Kmedrano101/px4_drone_dev/README.md

**Languages:** [English](README.md) | [Español](docs/README.es.md)

# px4_drone_dev

Development journal, tooling, and configuration for bringing up a custom PX4
drone toward autonomous **indoor navigation** — optical flow + LiDAR altitude,
magnetometer-free heading, and offboard control from a Raspberry Pi 4 companion
over ROS 2 / uXRCE-DDS.

> Work-in-progress engineering log: every fix is diagnosed from `.ulog` flight
> logs and documented step by step.

## Table of Contents

- [Overview](#overview)
- [Installation](#installation)
- [Usage](#usage)
- [Project Resources](#project-resources)
- [Contributing](#contributing)
- [License](#license)
- [Contact](#contact)

## Overview

**Hardware**
- **FC:** HKUST NxtPX4v2 (STM32H7) · FC#1 PX4 v1.17.0 (custom board build) · FC#2 PX4 v1.14.3 (vendor stock, 2nd drone)
- **Companion:** Raspberry Pi 4 · Ubuntu 24.04 · ROS 2 Jazzy
- **Sensors:** MicoAir MTF-01P (optical flow + 12 m LiDAR) · M100-5883 GPS/compass
- **Airframe:** Quad-X · T-Motor F90 2806.5 · HQProp 7040 · 6S

**Milestones**
- ✅ First flights (Stabilized / Altitude / Position outdoor, 0.71 m GPS hold)
- ✅ MTF-01P optical-flow + LiDAR integrated over MAVLink (TEL4/UART8)
- ✅ Offboard link RPi ⇄ FC via uXRCE-DDS (domain-id + px4_msgs aligned)
- ✅ Firmware optimized (removed FW/VTOL modules → FLASH 98.5% → 92%)
- ✅ 2nd drone (FC#2, vendor PX4 1.14.3) brought up — MTF-01P on TEL4 via SD `extras.txt`, 97 params migrated from FC#1
- ✅ FC#2 moved to **own PX4 1.17 build** (fork `nxt-dual-custom`, flash 83%) to enable the **QMC5883P compass**; offboard uXRCE-DDS re-verified on 1.17 (`px4_msgs` v1.17.0)
- ✅ **Outdoor GPS (ZED-F9P) validated** in open sky: autonomous sub-meter (`eph` 0.79–1.01 m, 16–21 sats, instant 3D fix) and **RTK cm** via IGN SPTR **VRS** (QGC NTRIP)
- ✅ **Outdoor estimation profile applied** (GPS fused `EKF2_GPS_CTRL=7`, baro height, flow/range off) with switchable **indoor↔outdoor profile files** (QGC *Load from file* or CLI); **motor-output map fixed** (motor 2↔3 cross-wiring → `PWM_MAIN_FUNC = 101,104,103,102`)
- ✅ **RTK validated in the field** (IGN NTRIP `VRS3M`): RTK-fixed 91/91 samples, position scatter 10 cm → **2 mm** (×59). Absolute location ≈ same (~1 m) as autonomous; the real win is **stability** for position hold and a quieter feed to EKF2 — see [report](reports/2026-10-27_campo-rtk-validado-fixed.md)
- ✅ Simulación Gazebo del dron real (RJX F450 + MTF-01P + D500) en la zona indoor escaneada
- ✅ Heading and position without a compass via **2D SLAM (LD19) → external vision**: EV fusion validated, ground arming in Offboard
- ✅ 360° obstacle stop from the raw 2D scan, honest EV variance, and onboard-computer load logged with every test
- 🔄 **Three MPC variants** built on the Pi: kinematic (4.4–9.3 ms), **MPC+** with a disturbance state (same binary, offset-free), and a **CTBR NMPC** with attitude in the model (2.7 ms mean, 5.9 ms max; engages only during the hold) — none flown yet
- 🔄 Altitude hold capped by **1D LiDAR saturation** over dark concrete: usable band ≤1 m
- ✅ **False obstacles on takeoff** solved: the 2D LiDAR's burst while the props spin (none with props stopped) is separated by the obstacle's **real width** — dust 0.03–0.09 m, a 40 cm pillar 0.40 m, a real obstacle 1.18–1.83 m
- ✅ **Bench without props (21-Oct):** all four cycles arm and reach TAKEOFF; forced disarm accepted in 12 ms
- ✅ **SLAM pose 1 Hz → 6.3 Hz**: karto rejected 70–80 % of LD19 scans (variable ray count, the 1.2 Hz behind the 18-Sep crash); a fixed-size scan relay lets all through — bench-measured, flight pending
- ⏳ In-flight PID vs MPC comparison (takeoff – 30 s hold – land at 0.8 m) — the 20-Oct outing was lost whole: CycloneDDS pinned to `eth0` with no Ethernet in the field (fixed and verified 21-Oct)
- ⏳ Full indoor navigation with 3D LiDAR (Livox + FAST-LIO)

## Installation

Analysis tooling (Python) for the `.ulog` scripts:

```bash
python3 -m venv .venv && source .venv/bin/activate
pip install pyulog matplotlib numpy
```

## Usage

Log analysis tools live in [`scripts/`](scripts/README.md) and generate **visual
plots**. Drop `.ulg` files in `scripts/input/` and run:

```bash
cd scripts
cp <your>.ulg input/
python3 analyze_temperature.py   # FC temperature (baro + IMU) with thresholds
python3 analyze_motor_noise.py   # motor outputs / saturation + torque
python3 analyze_takeoff.py       # takeoff diagnosis (altitude/motors/estimator)
```

Plots are written to `scripts/output/<log>/*.png`. See [`scripts/README.md`](scripts/README.md).

## Project Resources

**Documentation — engineering reports** (`docs/`, index in [docs/README.md](docs/README.md): `referencia/` stable docs · `planes/` dated plans & protocols · `publicaciones/` literature & paper proposals · `historico/` bring-up reports)
- [Platform: hardware, firmware & comms](docs/referencia/PLATAFORMA_HARDWARE.md) — full spec sheet + SUPER reference
- [Flight bring-up report](docs/historico/INFORME_VUELO_DRONE.md) — 4 problems solved, reference config, lessons
- [Motor-noise = yaw saturation](docs/historico/DIAGNOSTICO_RUIDO_MOTORES_YAW.md) — "loud motors on arming" root cause
- [Offboard RPi ⇄ FC (uXRCE-DDS)](docs/referencia/CONFIGURACION_OFFBOARD_RPI4.md) — companion link setup
- [MTF-01P flow + LiDAR integration](docs/referencia/INTEGRACION_MTF-01P_FLOW_LIDAR.md) — sensor bring-up saga
- [Indoor parameter reference](docs/referencia/PARAMETROS_INDOOR.md) — every GPS-free indoor param, ranked by importance
- [Direct MAVLink scripting](docs/referencia/CONEXION_MAVLINK_SCRIPTS.md) — talk to the FC over USB cable or radio without QGC
- [Working method](docs/referencia/METODOLOGIA_TRABAJO.md) — how analysis, reports, memory and FC changes are handled
- [2D-LiDAR EV test plan](docs/planes/2026-09-16_test_lidar2d_ev_offboard.md) — external vision from a 2D scanner, 1D LiDAR for altitude
- [Research gaps for publication](docs/publicaciones/2026-10-01_gaps_publicacion.md) — literature review vs what the group already has; where the next paper should go
- [Smooth-and-repeatable tuning plan](docs/planes/2026-10-19_plan_tuning_takeoff_hold_land.md) — the order of layers (mechanics → estimation → rates → thrust → outer loop), what to measure per phase, candidate targets
- [FC parameters for smooth flight](docs/planes/2026-10-20_parametros_vuelo_suave_produccion.md) — what the FC holds today (903-param dump), what PX4 does to our setpoints during takeoff, and what to change in order of effect
- [Bench tests without props](docs/planes/2026-10-21_pruebas_banco_sin_helices.md) — bench mode: forced disarm N s after TAKEOFF (21196) so the motors never wind up to 100 %; the order of tests before going back to the field
- [Outdoor GPS (ZED-F9P) position/altitude hold](docs/planes/2026-10-21_outdoor_gps_zedf9p_position_hold.md) — the F9P gives position but no heading; **outdoor estimation profile applied** (GPS fused), switchable indoor↔outdoor profiles (QGC/CLI), wiring and pre-arm checklist
- [Motor-output map & geometry](docs/referencia/PLATAFORMA_HARDWARE.md) — Quad-X geometry (`CA_ROTOR*`) vs output map (`PWM_MAIN_FUNC*`); the motor 2↔3 cross-wiring fix (2026-10-27)
- [Companion for a MID-360S](docs/planes/2026-10-19_companion_mid360s_slam.md) — what would replace the Pi for 3D LiDAR SLAM: evidence found, alternatives, acceptance test before buying

**Diagnostic reports** (companion / RPi) — see [`reports/`](reports/README.md)
- [MTF-01 EKF2 tuning — indoor flow](reports/2026-07-23_mtf01-ekf2-tuning.md)
- [FC#2 vendor 1.14.3 — MTF-01P + param migration](reports/2026-09-04_fc2-vendor-1143-mtf01p-migracion.md)

**Firmware versions** — see [backups/firmware/INDEX.md](backups/firmware/INDEX.md).

**Parameter profiles & backups** (`backups/`)
- [Indoor estimation profile](backups/profiles/perfil_indoor_flujo-lidar.params) — optical-flow + LiDAR, GPS off (`EKF2_GPS_CTRL=0`, height = range)
- [Outdoor estimation profile](backups/profiles/perfil_outdoor_gps.params) — GPS fused + compass, flow/range off (`EKF2_GPS_CTRL=7`, baro height) — **applied 2026-10-27**
- Partial param files (9 keys: estimation + RC/datalink-loss failsafe → **Land**) to switch via QGC *Tools → Load from file* or `scripts/mavlink/load_params.py`; they leave motors/tuning/battery untouched. Reboot the FC after switching.
- Full state snapshots (939 params, both with the motor-map fix): `backups/backup_fc_2026-10-27_outdoor-motorfix.params` (current) and `..._indoor-motorfix.params`.

**Reference platform** — this build replicates the [SUPER](https://github.com/hku-mars/SUPER) MAV
platform from HKU MaRS Lab ([hardware BOM](https://github.com/hku-mars/SUPER-Hardware)) as a base
for further work. Differences are tracked in [docs/referencia/PLATAFORMA_HARDWARE.md](docs/referencia/PLATAFORMA_HARDWARE.md) §7.
Each version ships the flashable `.px4` (QGC → Custom firmware) plus its
`board_config.diff` to rebuild; `.bin`/`.elf` are skipped.

## Contributing

Personal R&D journal — issues and suggestions welcome. See the reports in
`docs/` for the current state and open questions.

## License

Distributed under the [MIT License](LICENSE).

## Contact

Kevin Medrano — [kevin.ejem18@gmail.com](mailto:kevin.ejem18@gmail.com) · [@Kmedrano101](https://github.com/Kmedrano101)
