Kmedrano101/px4_drone_dev/reports/README.md

# reports/ — Reportes de diagnóstico (companion / RPi)

Canal compartido para **reportes generados desde la Raspberry Pi** (companion)
o durante pruebas de campo, para analizarlos y resolverlos.

Cada reporte describe **un problema concreto**: contexto, síntomas observados,
lecturas directas (consola MAVLink / topics ROS 2), e hipótesis a investigar.
Así el diagnóstico se hace con datos, no de memoria.

## Convención de nombres

```
YYYY-MM-DD_tema-corto.md
```
Ejemplos:
- `2026-07-23_mtf01-flow-no-valida-indoor.md`
- `2026-07-25_offboard-rx-cero.md`

## Cómo añadir un reporte desde la RPi

**Opción A — generar en la RPi y traer al repo (dev machine):**
```bash
# en la RPi: genera el reporte (ej. reporte.md)
scp reporte.md kmedrano@<dev-ip>:/home/kmedrano/src/drone_tunning/reports/
# en la dev machine:
cd /home/kmedrano/src/drone_tunning
git add reports/ && git commit -m "report: <tema>" && git push
```

**Opción B — clonar el repo en la RPi y commitear directo:**
```bash
# en la RPi (una vez):
git clone git@github.com:Kmedrano101/px4_drone_dev.git
# luego, por cada reporte:
cp reporte.md px4_drone_dev/reports/
cd px4_drone_dev && git pull --rebase && git add reports/ && git commit -m "report: <tema>" && git push
```

## Plantilla

Usa [`TEMPLATE.md`](TEMPLATE.md) como base para cada reporte nuevo — mantiene la
estructura consistente (contexto, síntoma, lecturas, hipótesis, qué no se tocó).

## Índice de reportes

| Fecha | Reporte | Estado |
|---|---|---|
| 2026-07-23 | [MTF-01 EKF2 tuning (flow no valida indoor)](2026-07-23_mtf01-ekf2-tuning.md) | ✅ Caso B confirmado en vuelo (2026-08-12): flow no fusiona sin yaw → necesita Livox+FAST-LIO |
| 2026-08-24 | [Motor M4 — tornillo haciendo contacto con bobina](2026-08-24_motor4-tornillo-bobina.md) | ✅ Resuelto — tornillo alejado, todos los motores OK |
| 2026-09-04 | [FC#2 vendor 1.14.3 — MTF-01P integrado + migración de params](2026-09-04_fc2-vendor-1143-mtf01p-migracion.md) | ✅ Sensor OK y 97 params migrados · ⛔ **sin magnetómetro** → mismo bloqueo de yaw que 2026-07-23 |
| 2026-09-08 | [EKF2 y flujo óptico en el SITL](2026-09-08_ekf2-no-converge-sitl.md) | ✅ **Resuelto** — 3 params EKF2 mal migrados rompían la fusión de flujo; ciclo completo verificado. Queda arranque intermitente ~2/7 |
| 2026-09-11 | [Vuelo offboard 1 — flujo cae en vuelo, failsafe, re-entrada en OFFBOARD](2026-09-11_offboard-vuelo1-flujo-failsafe.md) | 🔄 Flujo inútil >0.5 m en vuelo → failsafe a ALTCTL · ⚠️ PX4 volvió solo a OFFBOARD; lo paró el kill |
| 2026-09-11 | [Vuelo offboard 2 — escape vertical a ~25 m por el LiDAR](2026-09-11_offboard-vuelo2-runaway-rango.md) | ⛔ Casi accidente: `HGT_REF=2` + setpoint +2 m → el LiDAR baja al perder el suelo, el EKF cree descender y sube a ~25 m. Cambios obligatorios |
| 2026-09-11 | [Estimador y sensores en los vuelos offboard](2026-09-11_estimador-sensores-offboard.md) | ⚠️ Saltos de altura = cambios de instancia EKF (acelerómetro vertical malo en EKF0 el 43%); LiDAR sin retorno el 58% en el aire; sin magnetómetro |
| 2026-09-17 | [Validación SLAM 2D manual y mapa congelado](2026-09-17_slam-manual-ld19-congelado.md) | ✅ **Resuelto** — `minimum_travel_distance: 0.0` permite a `slam_toolbox` procesar scans sin odometría de ruedas; mapa y pose en vivo validados |
| 2026-09-17 | [Validación EV al EKF2 en tierra (Prueba 2)](2026-09-17_prueba2-ev-ekf-fusion-validada.md) | ✅ **Éxito** — EKF2 fusiona EV en `POSE_FRAME_NED`; `heading_good_for_control=True` sin mag, `eph=0.046 m`, handshake listo para vuelo |
| 2026-09-17 | [Armado en tierra en Offboard (Prueba 2b)](2026-09-17_prueba2b-armado-tierra-offboard-validado.md) | ✅ Offboard + armado + 5 s en ralentí + auto-desarme |
| 2026-09-18 | [Log 158 — takeoff EV y escape en el patrón en cruz](2026-09-18_takeoff-ev-log158-caida-stabilized.md) | ⛔ ~~Altura y LiDAR 1D bien~~ → **corregido el 2026-10-16**: el LiDAR 1D estaba saturando y el hover real fue a 1.66–1.82 m, no a 1 m (ver reporte del 2026-10-16). En la cruz el **SLAM 2D perdió el tracking** (1.2 Hz, ventana ±0.25 m) y el puente **ocultó su covarianza** → ~3 m de escape; la caída final fue Stabilized con gas a cero |
| 2026-10-14 | [MPC compilado en Raspberry Pi](2026-10-14_mpc-compilado-rpi.md) | 🔄 Compilado e instalado; solver y carga de bibliotecas verificados, sin prueba de vuelo |
| 2026-10-16 | [El LiDAR 1D del MTF-01P se satura sobre suelo oscuro](2026-10-16_lidar1d-saturacion-reflectividad.md) | 🔄 Causa identificada: reflectividad del hormigón (techo 2.53 m = spec del TF-Luna al 10 %). **Zona útil ≤1 m** · `EKF2_RNG_A_HMAX` debe bajar a 1.0 · corrige la altura del log 158 |
| 2026-10-16 | [El barómetro a 79 °C y la deriva de z en tierra](2026-10-16_baro-temperatura-deriva-z.md) | ⚠️ SPL06 sano (0 errores, 31 Hz) pero a **79 °C**; con la presión plana la z del EKF deriva **3 mm/s** (11 cm en 32 s). Confirma que la IMU no puede dar altura y que la ayuda del LiDAR 1D es la que ancla la z |
| 2026-10-19 | [PID y MPC — pruebas de 0.8 m detenidas por las guardas](2026-10-19_pid-mpc-pruebas-guardas-rpi.md) | ⚠️ PID abortó por `sigma_xy=0.311 m`; MPC subió parcialmente y aterrizó por obstáculo a 0.95 m. Las guardas funcionaron, pero no hay comparación PID vs MPC válida |
| 2026-10-20 | [Zona ciega circular y guarda SLAM en ciclos PID/MPC](2026-10-20_zona-ciega-circular-ciclos.md) | Radio ciego de 0.35 m en 360°; guarda SLAM desactivada en los launches de ciclo; 288 casos sintéticos correctos |
| 2026-10-20 | [Por qué los ciclos PID y MPC no despegaron: retornos falsos al despegar](2026-10-20_falsos-obstaculos-al-despegar.md) | ✅ **Causa cerrada** — no había obstáculo: con las hélices paradas el LiDAR ve 0 retornos en 655 barridos; con las hélices girando aparece una ráfaga de 0.6–1.6 s en todos los rumbos. Solución: **filtro de ancho mínimo de obstáculo** (el polvo da cuerdas de 0.03–0.09 m, un pilar de 40 cm da 0.40 m, el obstáculo real del accidente 1.18–1.83 m) |
| 2026-10-21 | [Las cinco corridas del 20-oct no volaron: CycloneDDS clavado a `eth0`](2026-10-21_cinco-corridas-sin-dds-eth0.md) | ✅ **Causa cerrada** — sin Ethernet en el campo Cyclone se negó a crear el dominio y ningún nodo arrancó (ni launch, ni bag, ni sysmon). `presence_required="false"` + `lo`, verificado en los tres estados de red; la webui ahora comprueba DDS antes de lanzar |
| 2026-10-21 | [Banco sin hélices: los cuatro ciclos arman, y el SLAM va a 1 Hz](2026-10-21_banco-cuatro-controladores-slam-1hz.md) | ✅ secuencia hasta el despegue demostrada en PID, MPC, MPC+ y CTBR; desarme forzado aceptado en 12 ms · ⛔ **karto rechaza el 70–80 % de los barridos del LD19** (número de rayos variable) → EV a ~1 Hz, el 1.2 Hz del accidente del 18-sep. Corrección: relay a tamaño fijo |
| 2026-10-21 | [Campo (tarde): ni un ciclo armó — altura y armado ciego](2026-10-21_campo-no-arma-altura-y-arming-ciego.md) | ✅ 3/4 eran altura > 1.0 m que la webui dejaba pasar (corregido, `8db02a3`) · 🔄 la 4ª es denegación real de armado de PX4; el motivo no va por DDS → `arm_watch.py` lo captura |
| 2026-10-27 | [Validación RTK en campo: fixed, dispersión 2 mm](2026-10-27_campo-rtk-validado-fixed.md) | ✅ RTK-fixed 91/91 con NTRIP (IGN VRS3M); dispersión 10 cm → **2 mm** (×59), offset autónomo 1.12 m. **Conclusión:** exactitud absoluta ≈ igual (mismo punto en el mapa), lo que aporta el RTK es **estabilidad** para position hold y para no cargar ruido al EKF2. El `eph` no refleja el RTK (fiarse de la dispersión) · ⏳ pendiente test EKF2 armado en tierra |
| 2026-10-27 | [Dos vuelos RTK suaves (logs 17 y 18)](2026-10-27_vuelos-rtk-suaves-logs17-18.md) | ✅ Vuelos sanos y suaves: RTK-fixed 92-97% en el aire, EKF test ratios <0.25, error de actitud ~2° RMS, 0 WARNINGs. **Autonomía real:** 1300 mAh ≈ **4.8 min** hasta 3.6 V/celda → **~10-12 min** proyectados con el pack de 4500 mAh (×2.37, revisión al alza del ~7-9 previo). Ojo: la dispersión "HOLD" del analizador NO es precisión en estático (hubo STAB manual) |
