Kmedrano101/px4_drone_dev/gazebo/models/indoor_clean_less_dense/meshes/baldosa.png

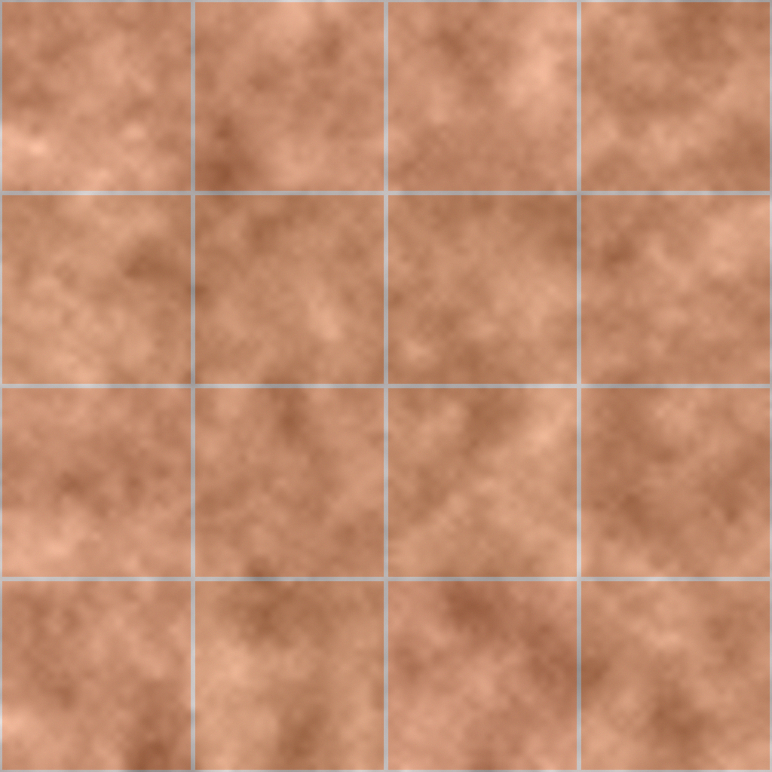
gazebo/models/indoor_clean_less_dense/meshes/baldosa.png
