Kmedrano101/px4_drone_dev/gazebo/models/indoor_clean_less_dense/meshes/ladrillo.png

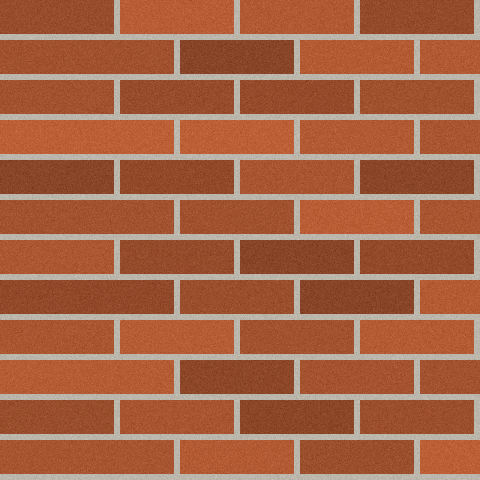
gazebo/models/indoor_clean_less_dense/meshes/ladrillo.png
