Kmedrano101/px4_drone_dev/hardware/base_rpi4/base_rpi4_render.png

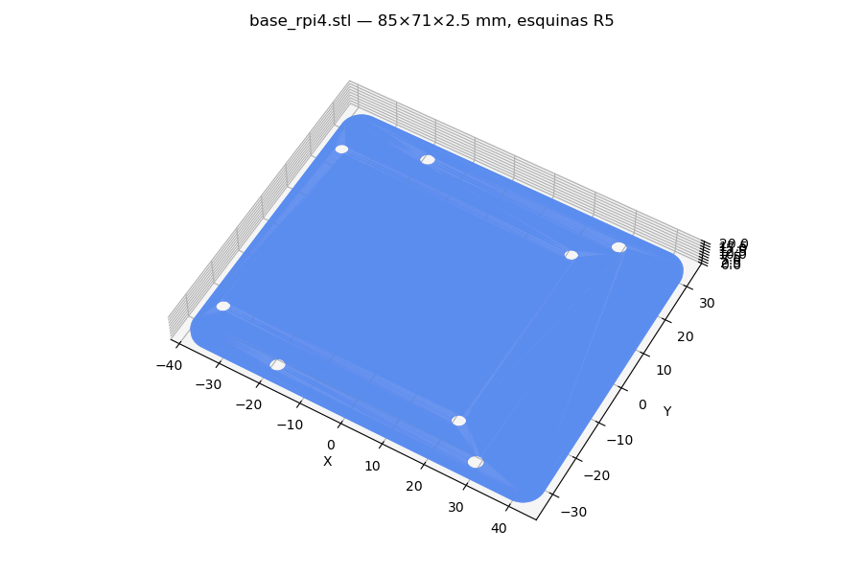
hardware/base_rpi4/base_rpi4_render.png
