Kmedrano101/px4_drone_dev/gazebo/models/indoor_clean_less_dense/meshes/indoor_clean_less_dense_collision.stl

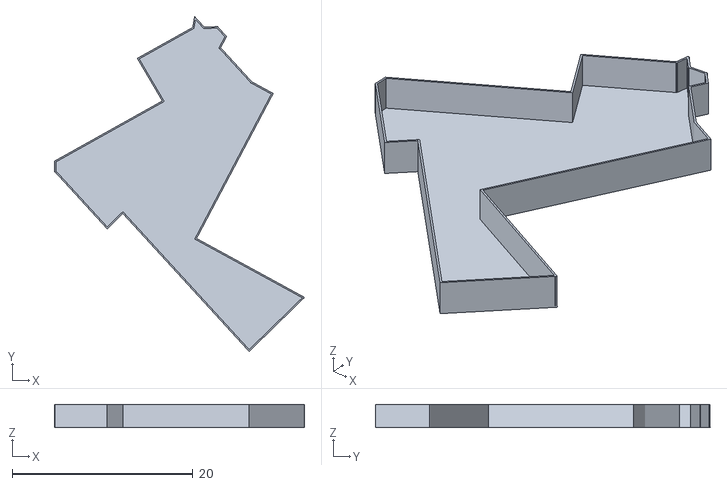
[picture p25: CAD file, 2026-09-10]
gazebo/models/indoor_clean_less_dense/meshes/indoor_clean_less_dense_collision.stl
27.7 x 37.1 x 2.60
