Kmedrano101/px4_drone_dev/gazebo/models/rjx_f450_base/meshes/prop_guard.stl

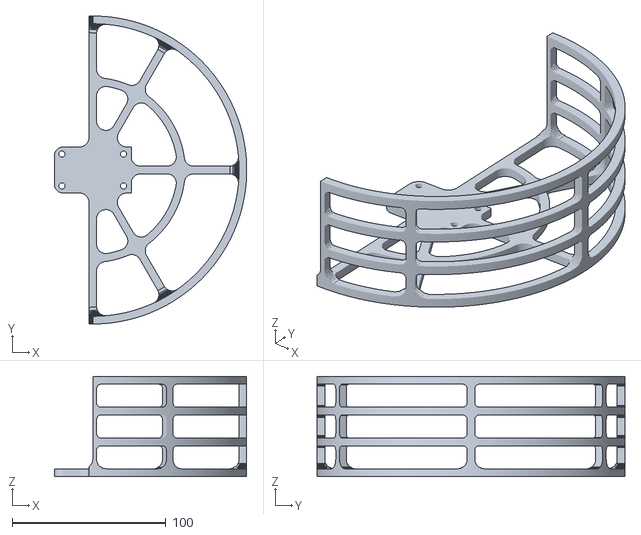
[picture p26: CAD file, 2026-09-10]
gazebo/models/rjx_f450_base/meshes/prop_guard.stl
125.0 x 200.0 x 65.0
