Kmedrano101/px4_drone_dev/hardware/base_rpi4/base_rpi4.stl

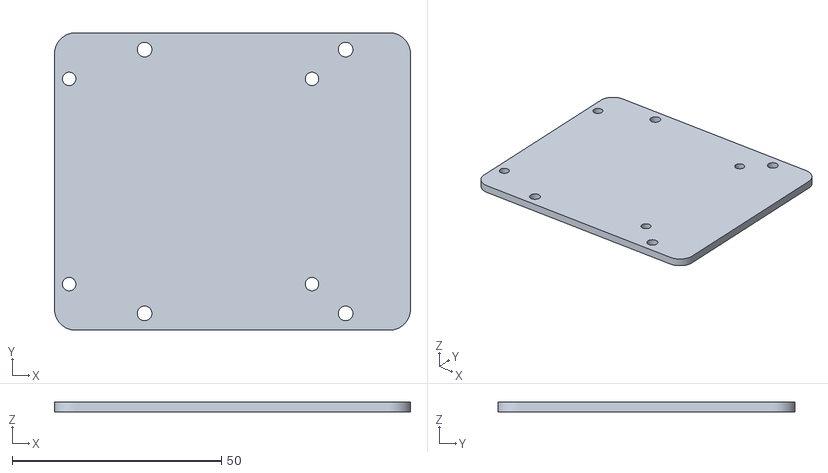
[picture p27: CAD file, 2026-10-23]
hardware/base_rpi4/base_rpi4.stl
85.0 x 71.0 x 2.50
