Kmedrano101/px4_drone_dev/hardware/bt560_mount/soporte_bt560.stl

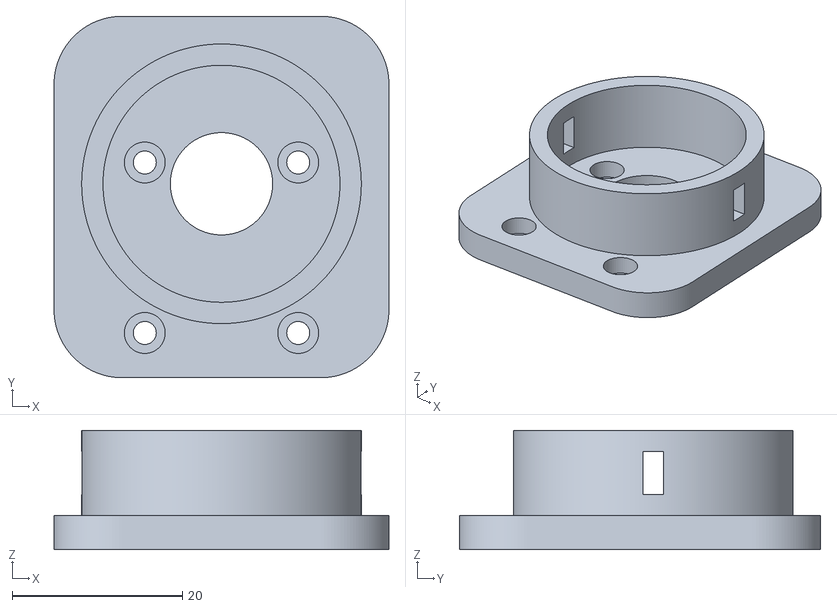
[picture p28: CAD file, 2026-10-22]
hardware/bt560_mount/soporte_bt560.stl
39.3 x 42.4 x 14.0
