Kmedrano101/px4_drone_dev/hardware/f9p_hat/f9p_hat.stl

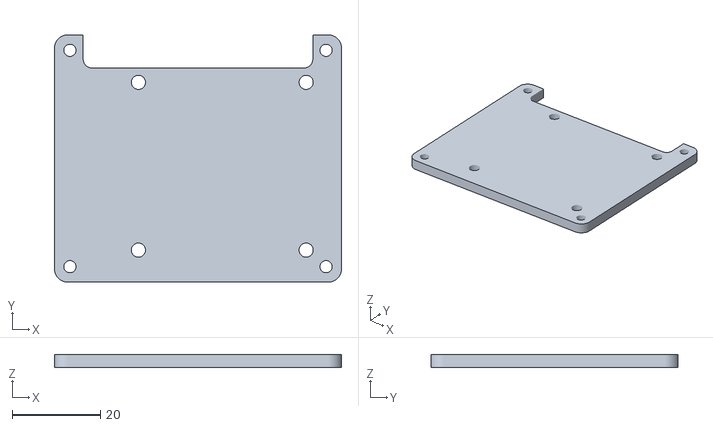
[picture p29: CAD file, 2026-10-22]
hardware/f9p_hat/f9p_hat.stl
65.0 x 56.0 x 3.00
