Kmedrano101/px4_drone_dev/gazebo/models/indoor_clean_less_dense/meshes/indoor_clean_less_dense.stl

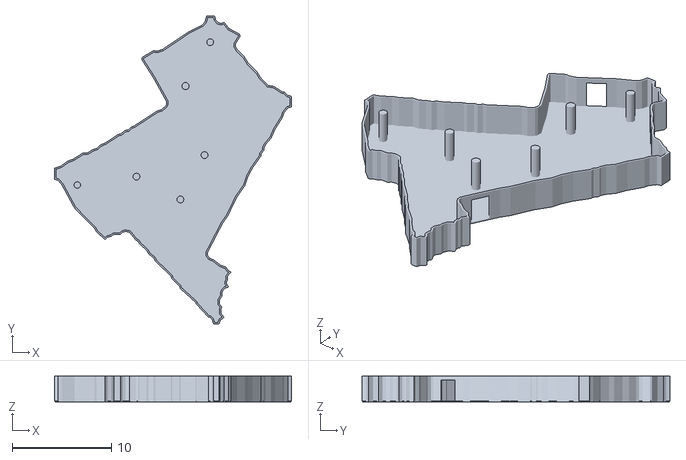
[picture p30: CAD file, 2026-09-10]
gazebo/models/indoor_clean_less_dense/meshes/indoor_clean_less_dense.stl
23.9 x 31.1 x 2.60
