Kmedrano101/px4_drone_dev/hardware/base_rpi4/base_rpi4_original.stl

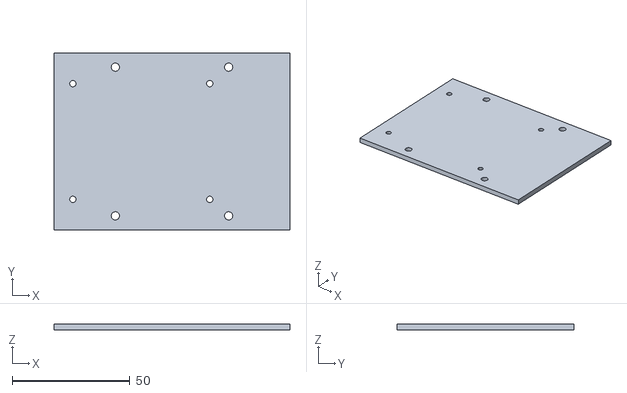
[picture p31: CAD file, 2026-10-23]
hardware/base_rpi4/base_rpi4_original.stl
100.0 x 75.0 x 2.50
