Kmedrano101/px4_drone_dev/gazebo/models/indoor_clean_less_dense/meshes/indoor_clean_less_dense_suelo.stl

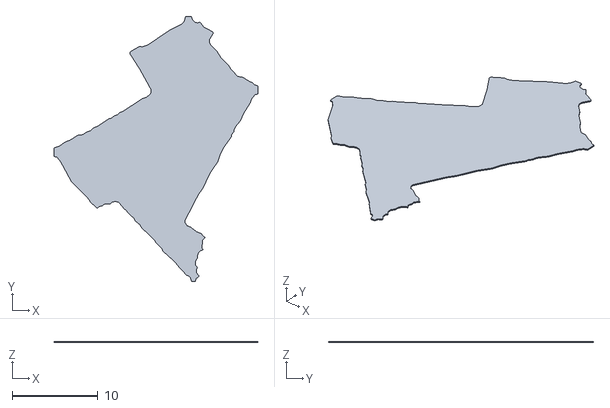
[picture p32: CAD file, 2026-09-10]
gazebo/models/indoor_clean_less_dense/meshes/indoor_clean_less_dense_suelo.stl
23.8 x 30.9 x 0.1
