Kmedrano101/px4_drone_dev/gazebo/models/indoor_clean_less_dense/meshes/indoor_clean_less_dense_columnas.stl

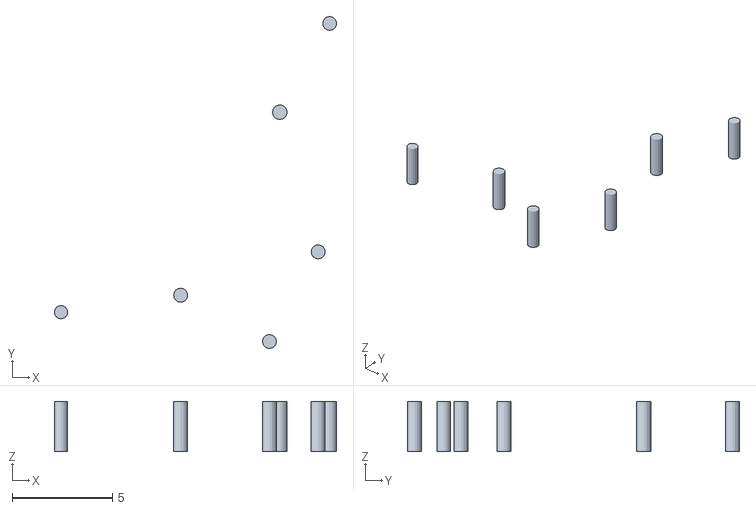
[picture p33: CAD file, 2026-09-10]
gazebo/models/indoor_clean_less_dense/meshes/indoor_clean_less_dense_columnas.stl
14.1 x 16.6 x 2.50
