Kmedrano101/px4_drone_dev/gazebo/models/indoor_clean_less_dense/meshes/indoor_clean_less_dense_muros.obj

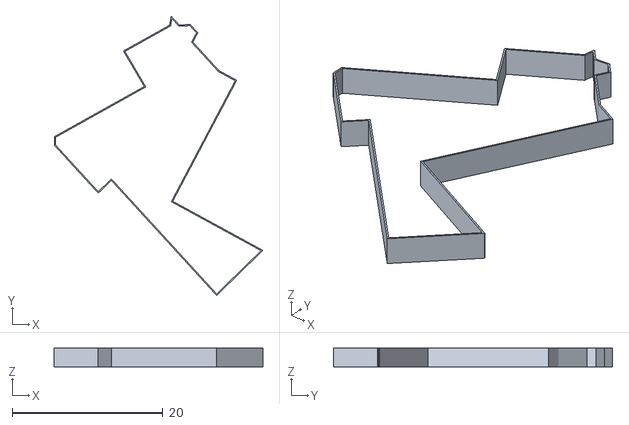
[picture p34: CAD file, 2026-09-10]
gazebo/models/indoor_clean_less_dense/meshes/indoor_clean_less_dense_muros.obj
27.7 x 37.0 x 2.50
