Kmedrano101/px4_drone_dev/(list of files, cad)

Other CAD files:
gazebo/models/indoor_clean_less_dense/meshes/indoor_clean_less_dense_suelo.obj
