Kmedrano101/px4_drone_dev/gazebo/models/rjx_f450_base/model.sdf

<?xml version="1.0" encoding="UTF-8"?>
<!--
  RJX F450 carbono - recreacion del drone real de pruebas indoor.
  Medidas y masas de docs/PLATAFORMA_HARDWARE.md:
    frame RJX F450, 450 mm de diagonal -> rotores a +-0.159 m
    T-Motor F90 2806.5 1300KV: 33.4 x 34.7 mm, 46.6 g, 2360 g de empuje con 7x4
    HQProp 7x4x3 tripala
    ESC MicoAir Bluejay-4IN1-60A: 44 x 43.5 x 5.2 mm
    FC NxtPX4v2: 27 x 32 x 8 mm
    Bateria Ovonic 6S1P 1300 mAh: 74 x 44 x 34 mm, 222 g
    Protectores impresos: malla real jaula_sin_patas.stl, arco de 100 mm de radio
  AUW modelada: 1.2 kg. Los sensores van en rjx_f450_indoor.
-->
<sdf version='1.9'>
  <model name='rjx_f450_base'>
    <self_collide>false</self_collide>
    <link name="base_link">
      <inertial>
        <mass>1.2</mass>
        <inertia>
          <ixx>0.017440</ixx><ixy>0</ixy><ixz>0</ixz>
          <iyy>0.017440</iyy><iyz>0</iyz><izz>0.032000</izz>
        </inertia>
      </inertial>
      <gravity>true</gravity>
      <velocity_decay/>
      <collision name="body_collision">
        <pose>0 0 0.02 0 0 0</pose>
        <geometry><box><size>0.17 0.17 0.10</size></box></geometry>
      </collision>
      <collision name="battery_collision">
        <pose>0 0 -0.035 0 0 0</pose>
        <geometry><box><size>0.078 0.050 0.050</size></box></geometry>
      </collision>
      <collision name="guard_0_collision">
        <pose>0.1591 -0.1591 0.052 0 0 -0.7854</pose>
        <geometry><box><size>0.20 0.20 0.065</size></box></geometry>
      </collision>
      <collision name="guard_1_collision">
        <pose>-0.1591 0.1591 0.052 0 0 2.3562</pose>
        <geometry><box><size>0.20 0.20 0.065</size></box></geometry>
      </collision>
      <collision name="guard_2_collision">
        <pose>0.1591 0.1591 0.052 0 0 0.7854</pose>
        <geometry><box><size>0.20 0.20 0.065</size></box></geometry>
      </collision>
      <collision name="guard_3_collision">
        <pose>-0.1591 -0.1591 0.052 0 0 -2.3562</pose>
        <geometry><box><size>0.20 0.20 0.065</size></box></geometry>
      </collision>
      <collision name="skid_0_collision">
        <pose>0 0.1050 -0.16 0 1.5708 0</pose>
        <geometry><cylinder><radius>0.009</radius><length>0.28</length></cylinder></geometry>
        <surface><friction><ode><mu>1.0</mu><mu2>1.0</mu2></ode></friction></surface>
      </collision>
      <collision name="skid_1_collision">
        <pose>0 -0.1050 -0.16 0 1.5708 0</pose>
        <geometry><cylinder><radius>0.009</radius><length>0.28</length></cylinder></geometry>
        <surface><friction><ode><mu>1.0</mu><mu2>1.0</mu2></ode></friction></surface>
      </collision>
      <visual name="plate_bottom">
        <pose>0 0 0 0 0 0</pose>
        <geometry><box><size>0.16 0.16 0.0025</size></box></geometry>
        <material>
          <ambient>0.07 0.07 0.08 1</ambient>
          <diffuse>0.07 0.07 0.08 1</diffuse>
          <specular>0.25 0.25 0.25 1</specular>
        </material>
      </visual>
      <visual name="plate_top">
        <pose>0 0 0.032 0 0 0</pose>
        <geometry><box><size>0.155 0.155 0.002</size></box></geometry>
        <material>
          <ambient>0.07 0.07 0.08 1</ambient>
          <diffuse>0.07 0.07 0.08 1</diffuse>
          <specular>0.25 0.25 0.25 1</specular>
        </material>
      </visual>
      <visual name="esc_4in1">
        <pose>0 0 0.0075 0 0 0</pose>
        <geometry><box><size>0.044 0.0435 0.0052</size></box></geometry>
        <material>
          <ambient>0.09 0.09 0.10 1</ambient>
          <diffuse>0.09 0.09 0.10 1</diffuse>
          <specular>0.2 0.2 0.2 1</specular>
        </material>
      </visual>
      <visual name="fc_nxtpx4v2">
        <pose>0 0 0.0385 0 0 0</pose>
        <geometry><box><size>0.032 0.027 0.008</size></box></geometry>
        <material>
          <ambient>0.10 0.10 0.11 1</ambient>
          <diffuse>0.10 0.10 0.11 1</diffuse>
          <specular>0.2 0.2 0.2 1</specular>
        </material>
      </visual>
      <visual name="arm_0">
        <pose>0.0902 -0.0902 0.016 0 1.5708 -0.7854</pose>
        <geometry><cylinder><radius>0.008</radius><length>0.195</length></cylinder></geometry>
        <material>
          <ambient>0.07 0.07 0.08 1</ambient>
          <diffuse>0.07 0.07 0.08 1</diffuse>
          <specular>0.2 0.2 0.2 1</specular>
        </material>
      </visual>
      <visual name="motor_0">
        <pose>0.1591 -0.1591 0.0425 0 0 0</pose>
        <geometry><cylinder><radius>0.0167</radius><length>0.0247</length></cylinder></geometry>
        <material>
          <ambient>0.12 0.12 0.13 1</ambient>
          <diffuse>0.12 0.12 0.13 1</diffuse>
          <specular>0.4 0.4 0.4 1</specular>
        </material>
      </visual>
      <visual name="motor_bell_0">
        <pose>0.1591 -0.1591 0.0565 0 0 0</pose>
        <geometry><cylinder><radius>0.0167</radius><length>0.01</length></cylinder></geometry>
        <material>
          <ambient>0.20 0.20 0.22 1</ambient>
          <diffuse>0.20 0.20 0.22 1</diffuse>
          <specular>0.5 0.5 0.5 1</specular>
        </material>
      </visual>
      <visual name="motor_shaft_0">
        <pose>0.1591 -0.1591 0.0635 0 0 0</pose>
        <geometry><cylinder><radius>0.002</radius><length>0.006</length></cylinder></geometry>
        <material>
          <ambient>0.6 0.6 0.62 1</ambient>
          <diffuse>0.6 0.6 0.62 1</diffuse>
          <specular>0.7 0.7 0.7 1</specular>
        </material>
      </visual>
      <visual name="prop_guard_0">
        <pose>0.1591 -0.1591 0.052 0 0 -0.7854</pose>
        <geometry><mesh>
          <uri>model://rjx_f450_base/meshes/prop_guard.stl</uri>
          <scale>0.001 0.001 0.001</scale>
        </mesh></geometry>
        <material>
          <ambient>0.72 0.06 0.09 1</ambient>
          <diffuse>0.72 0.06 0.09 1</diffuse>
          <specular>0.15 0.05 0.05 1</specular>
        </material>
      </visual>
      <visual name="arm_1">
        <pose>-0.0902 0.0902 0.016 0 1.5708 2.3562</pose>
        <geometry><cylinder><radius>0.008</radius><length>0.195</length></cylinder></geometry>
        <material>
          <ambient>0.07 0.07 0.08 1</ambient>
          <diffuse>0.07 0.07 0.08 1</diffuse>
          <specular>0.2 0.2 0.2 1</specular>
        </material>
      </visual>
      <visual name="motor_1">
        <pose>-0.1591 0.1591 0.0425 0 0 0</pose>
        <geometry><cylinder><radius>0.0167</radius><length>0.0247</length></cylinder></geometry>
        <material>
          <ambient>0.12 0.12 0.13 1</ambient>
          <diffuse>0.12 0.12 0.13 1</diffuse>
          <specular>0.4 0.4 0.4 1</specular>
        </material>
      </visual>
      <visual name="motor_bell_1">
        <pose>-0.1591 0.1591 0.0565 0 0 0</pose>
        <geometry><cylinder><radius>0.0167</radius><length>0.01</length></cylinder></geometry>
        <material>
          <ambient>0.20 0.20 0.22 1</ambient>
          <diffuse>0.20 0.20 0.22 1</diffuse>
          <specular>0.5 0.5 0.5 1</specular>
        </material>
      </visual>
      <visual name="motor_shaft_1">
        <pose>-0.1591 0.1591 0.0635 0 0 0</pose>
        <geometry><cylinder><radius>0.002</radius><length>0.006</length></cylinder></geometry>
        <material>
          <ambient>0.6 0.6 0.62 1</ambient>
          <diffuse>0.6 0.6 0.62 1</diffuse>
          <specular>0.7 0.7 0.7 1</specular>
        </material>
      </visual>
      <visual name="prop_guard_1">
        <pose>-0.1591 0.1591 0.052 0 0 2.3562</pose>
        <geometry><mesh>
          <uri>model://rjx_f450_base/meshes/prop_guard.stl</uri>
          <scale>0.001 0.001 0.001</scale>
        </mesh></geometry>
        <material>
          <ambient>0.72 0.06 0.09 1</ambient>
          <diffuse>0.72 0.06 0.09 1</diffuse>
          <specular>0.15 0.05 0.05 1</specular>
        </material>
      </visual>
      <visual name="arm_2">
        <pose>0.0902 0.0902 0.016 0 1.5708 0.7854</pose>
        <geometry><cylinder><radius>0.008</radius><length>0.195</length></cylinder></geometry>
        <material>
          <ambient>0.07 0.07 0.08 1</ambient>
          <diffuse>0.07 0.07 0.08 1</diffuse>
          <specular>0.2 0.2 0.2 1</specular>
        </material>
      </visual>
      <visual name="motor_2">
        <pose>0.1591 0.1591 0.0425 0 0 0</pose>
        <geometry><cylinder><radius>0.0167</radius><length>0.0247</length></cylinder></geometry>
        <material>
          <ambient>0.12 0.12 0.13 1</ambient>
          <diffuse>0.12 0.12 0.13 1</diffuse>
          <specular>0.4 0.4 0.4 1</specular>
        </material>
      </visual>
      <visual name="motor_bell_2">
        <pose>0.1591 0.1591 0.0565 0 0 0</pose>
        <geometry><cylinder><radius>0.0167</radius><length>0.01</length></cylinder></geometry>
        <material>
          <ambient>0.20 0.20 0.22 1</ambient>
          <diffuse>0.20 0.20 0.22 1</diffuse>
          <specular>0.5 0.5 0.5 1</specular>
        </material>
      </visual>
      <visual name="motor_shaft_2">
        <pose>0.1591 0.1591 0.0635 0 0 0</pose>
        <geometry><cylinder><radius>0.002</radius><length>0.006</length></cylinder></geometry>
        <material>
          <ambient>0.6 0.6 0.62 1</ambient>
          <diffuse>0.6 0.6 0.62 1</diffuse>
          <specular>0.7 0.7 0.7 1</specular>
        </material>
      </visual>
      <visual name="prop_guard_2">
        <pose>0.1591 0.1591 0.052 0 0 0.7854</pose>
        <geometry><mesh>
          <uri>model://rjx_f450_base/meshes/prop_guard.stl</uri>
          <scale>0.001 0.001 0.001</scale>
        </mesh></geometry>
        <material>
          <ambient>0.72 0.06 0.09 1</ambient>
          <diffuse>0.72 0.06 0.09 1</diffuse>
          <specular>0.15 0.05 0.05 1</specular>
        </material>
      </visual>
      <visual name="arm_3">
        <pose>-0.0902 -0.0902 0.016 0 1.5708 -2.3562</pose>
        <geometry><cylinder><radius>0.008</radius><length>0.195</length></cylinder></geometry>
        <material>
          <ambient>0.07 0.07 0.08 1</ambient>
          <diffuse>0.07 0.07 0.08 1</diffuse>
          <specular>0.2 0.2 0.2 1</specular>
        </material>
      </visual>
      <visual name="motor_3">
        <pose>-0.1591 -0.1591 0.0425 0 0 0</pose>
        <geometry><cylinder><radius>0.0167</radius><length>0.0247</length></cylinder></geometry>
        <material>
          <ambient>0.12 0.12 0.13 1</ambient>
          <diffuse>0.12 0.12 0.13 1</diffuse>
          <specular>0.4 0.4 0.4 1</specular>
        </material>
      </visual>
      <visual name="motor_bell_3">
        <pose>-0.1591 -0.1591 0.0565 0 0 0</pose>
        <geometry><cylinder><radius>0.0167</radius><length>0.01</length></cylinder></geometry>
        <material>
          <ambient>0.20 0.20 0.22 1</ambient>
          <diffuse>0.20 0.20 0.22 1</diffuse>
          <specular>0.5 0.5 0.5 1</specular>
        </material>
      </visual>
      <visual name="motor_shaft_3">
        <pose>-0.1591 -0.1591 0.0635 0 0 0</pose>
        <geometry><cylinder><radius>0.002</radius><length>0.006</length></cylinder></geometry>
        <material>
          <ambient>0.6 0.6 0.62 1</ambient>
          <diffuse>0.6 0.6 0.62 1</diffuse>
          <specular>0.7 0.7 0.7 1</specular>
        </material>
      </visual>
      <visual name="prop_guard_3">
        <pose>-0.1591 -0.1591 0.052 0 0 -2.3562</pose>
        <geometry><mesh>
          <uri>model://rjx_f450_base/meshes/prop_guard.stl</uri>
          <scale>0.001 0.001 0.001</scale>
        </mesh></geometry>
        <material>
          <ambient>0.72 0.06 0.09 1</ambient>
          <diffuse>0.72 0.06 0.09 1</diffuse>
          <specular>0.15 0.05 0.05 1</specular>
        </material>
      </visual>
      <visual name="skid_0">
        <pose>0 0.1050 -0.16 0 1.5708 0</pose>
        <geometry><cylinder><radius>0.009</radius><length>0.28</length></cylinder></geometry>
        <material>
          <ambient>0.07 0.07 0.08 1</ambient>
          <diffuse>0.07 0.07 0.08 1</diffuse>
          <specular>0.2 0.2 0.2 1</specular>
        </material>
      </visual>
      <visual name="skid_0_cap_0">
        <pose>0.1400 0.1050 -0.16 0 1.5708 0</pose>
        <geometry><cylinder><radius>0.0105</radius><length>0.012</length></cylinder></geometry>
        <material>
          <ambient>0.12 0.12 0.13 1</ambient>
          <diffuse>0.12 0.12 0.13 1</diffuse>
          <specular>0.1 0.1 0.1 1</specular>
        </material>
      </visual>
      <visual name="skid_0_cap_1">
        <pose>-0.1400 0.1050 -0.16 0 1.5708 0</pose>
        <geometry><cylinder><radius>0.0105</radius><length>0.012</length></cylinder></geometry>
        <material>
          <ambient>0.12 0.12 0.13 1</ambient>
          <diffuse>0.12 0.12 0.13 1</diffuse>
          <specular>0.1 0.1 0.1 1</specular>
        </material>
      </visual>
      <visual name="strut_0">
        <pose>0 0.0800 -0.0810 0.3065 0 0</pose>
        <geometry><cylinder><radius>0.009</radius><length>0.16572265988693277</length></cylinder></geometry>
        <material>
          <ambient>0.07 0.07 0.08 1</ambient>
          <diffuse>0.07 0.07 0.08 1</diffuse>
          <specular>0.2 0.2 0.2 1</specular>
        </material>
      </visual>
      <visual name="skid_1">
        <pose>0 -0.1050 -0.16 0 1.5708 0</pose>
        <geometry><cylinder><radius>0.009</radius><length>0.28</length></cylinder></geometry>
        <material>
          <ambient>0.07 0.07 0.08 1</ambient>
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
        <geometry><box><size>0.021 0.016 0.014</size></box></geometry>
        <material>
          <ambient>0.50 0.50 0.53 1</ambient>
          <diffuse>0.50 0.50 0.53 1</diffuse>
          <specular>0.5 0.5 0.5 1</specular>
        </material>
      </visual>
      <visual name="rpi4_soc">
        <pose>-0.005 0 0.0665 0 0 0</pose>
        <geometry><box><size>0.015 0.015 0.0022</size></box></geometry>
        <material>
          <ambient>0.15 0.15 0.16 1</ambient>
          <diffuse>0.15 0.15 0.16 1</diffuse>
          <specular>0.1 0.1 0.1 1</specular>
        </material>
      </visual>
      <visual name="standoff_hi_0">
        <pose>0.0390 0.0240 0.081 0 0 0</pose>
        <geometry><cylinder><radius>0.0025</radius><length>0.03</length></cylinder></geometry>
        <material>
          <ambient>0.6 0.6 0.62 1</ambient>
          <diffuse>0.6 0.6 0.62 1</diffuse>
          <specular>0.5 0.5 0.5 1</specular>
        </material>
      </visual>
      <visual name="standoff_hi_1">
        <pose>0.0390 -0.0240 0.081 0 0 0</pose>
        <geometry><cylinder><radius>0.0025</radius><length>0.03</length></cylinder></geometry>
        <material>
          <ambient>0.6 0.6 0.62 1</ambient>
          <diffuse>0.6 0.6 0.62 1</diffuse>
          <specular>0.5 0.5 0.5 1</specular>
        </material>
      </visual>
      <visual name="standoff_hi_2">
        <pose>-0.0390 0.0240 0.081 0 0 0</pose>
        <geometry><cylinder><radius>0.0025</radius><length>0.03</length></cylinder></geometry>
        <material>
          <ambient>0.6 0.6 0.62 1</ambient>
          <diffuse>0.6 0.6 0.62 1</diffuse>
          <specular>0.5 0.5 0.5 1</specular>
        </material>
      </visual>
      <visual name="standoff_hi_3">
        <pose>-0.0390 -0.0240 0.081 0 0 0</pose>
        <geometry><cylinder><radius>0.0025</radius><length>0.03</length></cylinder></geometry>
        <material>
          <ambient>0.6 0.6 0.62 1</ambient>
          <diffuse>0.6 0.6 0.62 1</diffuse>
          <specular>0.5 0.5 0.5 1</specular>
        </material>
      </visual>
      <visual name="deck_plate">
        <pose>0 0 0.0975 0 0 0</pose>
        <geometry><box><size>0.098 0.072 0.004</size></box></geometry>
        <material>
          <ambient>0.85 0.78 0.60 1</ambient>
          <diffuse>0.85 0.78 0.60 1</diffuse>
          <specular>0.08 0.08 0.08 1</specular>
        </material>
      </visual>
      <visual name="rpi4_fan">
        <pose>0.012 0 0.0755 0 0 0</pose>
        <geometry><cylinder><radius>0.0145</radius><length>0.01</length></cylinder></geometry>
        <material>
          <ambient>0.12 0.12 0.13 1</ambient>
          <diffuse>0.12 0.12 0.13 1</diffuse>
          <specular>0.2 0.2 0.2 1</specular>
        </material>
      </visual>
      <sensor name="air_pressure_sensor" type="air_pressure">
        <gz_frame_id>base_link</gz_frame_id>
        <always_on>1</always_on>
        <update_rate>50</update_rate>
        <air_pressure>
          <!-- Noise modeled after BMP390 -->
          <pressure>
            <noise type="gaussian">
              <mean>0</mean>
              <stddev>3</stddev>
            </noise>
          </pressure>
        </air_pressure>
      </sensor>
      <sensor name="magnetometer_sensor" type="magnetometer">
        <gz_frame_id>base_link</gz_frame_id>
        <always_on>1</always_on>
        <update_rate>100</update_rate>
        <magnetometer>
          <!-- TODO: update to fix units and coordinate system when we move past Harmonic -->
          <!-- See https://github.com/gazebosim/gz-sim/pull/2460 -->
          <!-- 3mgauss RMS: NOTE: noise is in tesla but sensor reports data in gauss -->
          <!-- Noise modeled after IIS2MDC -->
          <x>
            <noise type="gaussian">
              <stddev>0.0001</stddev>
            </noise>
          </x>
          <y>
            <noise type="gaussian">
              <stddev>0.0001</stddev>
            </noise>
          </y>
          <z>
            <noise type="gaussian">
              <stddev>0.0001</stddev>
            </noise>
          </z>
        </magnetometer>
      </sensor>
      <sensor name="imu_sensor" type="imu">
        <gz_frame_id>base_link</gz_frame_id>
        <always_on>1</always_on>
        <update_rate>200</update_rate>
        <imu>
          <angular_velocity>
            <!-- Noise modeled after IIM42653 -->
            <!-- 0.05 deg/s converted to rad/s -->
            <x>
              <noise type="gaussian">
                <mean>0.0</mean>
                <stddev>0.0008726646</stddev>
              </noise>
            </x>
            <y>
              <noise type="gaussian">
                <mean>0.0</mean>
                <stddev>0.0008726646</stddev>
              </noise>
            </y>
            <z>
              <noise type="gaussian">
                <mean>0.0</mean>
                <stddev>0.0008726646</stddev>
              </noise>
            </z>
          </angular_velocity>
          <linear_acceleration>
            <!-- Noise modeled after IIM42653 -->
            <!-- X & Y axis: 0.65 mg-rms converted to m/ss -->
            <x>
              <noise type="gaussian">
                <mean>0.0</mean>
                <stddev>0.00637</stddev>
              </noise>
            </x>
            <y>
              <noise type="gaussian">
                <mean>0.0</mean>
                <stddev>0.00637</stddev>
              </noise>
            </y>
            <!-- Z axis: 0.70 mg-rms converted to m/ss-->
            <z>
              <noise type="gaussian">
                <mean>0.0</mean>
                <stddev>0.00686</stddev>
              </noise>
            </z>
          </linear_acceleration>
        </imu>
      </sensor>
      <sensor name="navsat_sensor" type="navsat">
        <gz_frame_id>base_link</gz_frame_id>
        <always_on>1</always_on>
        <update_rate>30</update_rate>
      </sensor>
    </link>
    <link name="rotor_0">
      <gravity>true</gravity>
      <self_collide>false</self_collide>
      <velocity_decay/>
      <pose>0.1591 -0.1591 0.062 0 0 0</pose>
      <inertial>
        <mass>0.0095</mass>
        <inertia>
          <ixx>2.1e-07</ixx><ixy>0</ixy><ixz>0</ixz>
          <iyy>1.05e-05</iyy><iyz>0</iyz><izz>1.07e-05</izz>
        </inertia>
      </inertial>
      <visual name="rotor_0_hub">
        <geometry><cylinder><radius>0.008</radius><length>0.006</length></cylinder></geometry>
        <material>
          <ambient>0.15 0.15 0.16 1</ambient>
          <diffuse>0.15 0.15 0.16 1</diffuse>
          <specular>0.1 0.1 0.1 1</specular>
        </material>
      </visual>
      <visual name="rotor_0_blade_0">
        <pose>0.0480 0.0000 0 0 0.06 0.0000</pose>
        <geometry><box><size>0.081 0.017 0.0016</size></box></geometry>
        <material>
          <ambient>0.24 0.26 0.20 1</ambient>
          <diffuse>0.24 0.26 0.20 1</diffuse>
          <specular>0.15 0.15 0.15 1</specular>
        </material>
      </visual>
      <visual name="rotor_0_blade_1">
        <pose>-0.0240 0.0416 0 0 0.06 2.0944</pose>
        <geometry><box><size>0.081 0.017 0.0016</size></box></geometry>
        <material>
          <ambient>0.24 0.26 0.20 1</ambient>
          <diffuse>0.24 0.26 0.20 1</diffuse>
          <specular>0.15 0.15 0.15 1</specular>
        </material>
      </visual>
      <visual name="rotor_0_blade_2">
        <pose>-0.0240 -0.0416 0 0 0.06 4.1888</pose>
        <geometry><box><size>0.081 0.017 0.0016</size></box></geometry>
        <material>
          <ambient>0.24 0.26 0.20 1</ambient>
          <diffuse>0.24 0.26 0.20 1</diffuse>
          <specular>0.15 0.15 0.15 1</specular>
        </material>
      </visual>
      <collision name="rotor_0_collision">
        <geometry><box><size>0.1778 0.017 0.0016</size></box></geometry>
        <surface><contact><ode><min_depth>0.001</min_depth><max_vel>0</max_vel></ode></contact><friction><ode/></friction></surface>
      </collision>
    </link>
    <joint name="rotor_0_joint" type="revolute">
      <parent>base_link</parent>
      <child>rotor_0</child>
      <axis>
        <xyz>0 0 1</xyz>
        <limit><lower>-1e+16</lower><upper>1e+16</upper></limit>
        <dynamics><spring_reference>0</spring_reference><spring_stiffness>0</spring_stiffness></dynamics>
      </axis>
    </joint>
    <link name="rotor_1">
      <gravity>true</gravity>
      <self_collide>false</self_collide>
      <velocity_decay/>
      <pose>-0.1591 0.1591 0.062 0 0 0</pose>
      <inertial>
        <mass>0.0095</mass>
        <inertia>
          <ixx>2.1e-07</ixx><ixy>0</ixy><ixz>0</ixz>
          <iyy>1.05e-05</iyy><iyz>0</iyz><izz>1.07e-05</izz>
        </inertia>
      </inertial>
      <visual name="rotor_1_hub">
        <geometry><cylinder><radius>0.008</radius><length>0.006</length></cylinder></geometry>
        <material>
          <ambient>0.15 0.15 0.16 1</ambient>
          <diffuse>0.15 0.15 0.16 1</diffuse>
          <specular>0.1 0.1 0.1 1</specular>
        </material>
      </visual>
      <visual name="rotor_1_blade_0">
        <pose>0.0480 0.0000 0 0 0.06 0.0000</pose>
        <geometry><box><size>0.081 0.017 0.0016</size></box></geometry>
        <material>
          <ambient>0.24 0.26 0.20 1</ambient>
          <diffuse>0.24 0.26 0.20 1</diffuse>
          <specular>0.15 0.15 0.15 1</specular>
        </material>
      </visual>
      <visual name="rotor_1_blade_1">
        <pose>-0.0240 0.0416 0 0 0.06 2.0944</pose>
        <geometry><box><size>0.081 0.017 0.0016</size></box></geometry>
        <material>
          <ambient>0.24 0.26 0.20 1</ambient>
          <diffuse>0.24 0.26 0.20 1</diffuse>
          <specular>0.15 0.15 0.15 1</specular>
        </material>
      </visual>
      <visual name="rotor_1_blade_2">
        <pose>-0.0240 -0.0416 0 0 0.06 4.1888</pose>
        <geometry><box><size>0.081 0.017 0.0016</size></box></geometry>
        <material>
          <ambient>0.24 0.26 0.20 1</ambient>
          <diffuse>0.24 0.26 0.20 1</diffuse>
          <specular>0.15 0.15 0.15 1</specular>
        </material>
      </visual>
      <collision name="rotor_1_collision">
        <geometry><box><size>0.1778 0.017 0.0016</size></box></geometry>
        <surface><contact><ode><min_depth>0.001</min_depth><max_vel>0</max_vel></ode></contact><friction><ode/></friction></surface>
      </collision>
    </link>
    <joint name="rotor_1_joint" type="revolute">
      <parent>base_link</parent>
      <child>rotor_1</child>
      <axis>
        <xyz>0 0 1</xyz>
        <limit><lower>-1e+16</lower><upper>1e+16</upper></limit>
        <dynamics><spring_reference>0</spring_reference><spring_stiffness>0</spring_stiffness></dynamics>
      </axis>
    </joint>
    <link name="rotor_2">
      <gravity>true</gravity>
      <self_collide>false</self_collide>
      <velocity_decay/>
      <pose>0.1591 0.1591 0.062 0 0 0</pose>
      <inertial>
        <mass>0.0095</mass>
        <inertia>
          <ixx>2.1e-07</ixx><ixy>0</ixy><ixz>0</ixz>
          <iyy>1.05e-05</iyy><iyz>0</iyz><izz>1.07e-05</izz>
        </inertia>
      </inertial>
      <visual name="rotor_2_hub">
        <geometry><cylinder><radius>0.008</radius><length>0.006</length></cylinder></geometry>
        <material>
          <ambient>0.15 0.15 0.16 1</ambient>
          <diffuse>0.15 0.15 0.16 1</diffuse>
          <specular>0.1 0.1 0.1 1</specular>
        </material>
      </visual>
      <visual name="rotor_2_blade_0">
        <pose>0.0480 0.0000 0 0 0.06 0.0000</pose>
        <geometry><box><size>0.081 0.017 0.0016</size></box></geometry>
        <material>
          <ambient>0.24 0.26 0.20 1</ambient>
          <diffuse>0.24 0.26 0.20 1</diffuse>
          <specular>0.15 0.15 0.15 1</specular>
        </material>
      </visual>
      <visual name="rotor_2_blade_1">
        <pose>-0.0240 0.0416 0 0 0.06 2.0944</pose>
        <geometry><box><size>0.081 0.017 0.0016</size></box></geometry>
        <material>
          <ambient>0.24 0.26 0.20 1</ambient>
          <diffuse>0.24 0.26 0.20 1</diffuse>
          <specular>0.15 0.15 0.15 1</specular>
        </material>
      </visual>
      <visual name="rotor_2_blade_2">
        <pose>-0.0240 -0.0416 0 0 0.06 4.1888</pose>
        <geometry><box><size>0.081 0.017 0.0016</size></box></geometry>
        <material>
          <ambient>0.24 0.26 0.20 1</ambient>
          <diffuse>0.24 0.26 0.20 1</diffuse>
          <specular>0.15 0.15 0.15 1</specular>
        </material>
      </visual>
      <collision name="rotor_2_collision">
        <geometry><box><size>0.1778 0.017 0.0016</size></box></geometry>
        <surface><contact><ode><min_depth>0.001</min_depth><max_vel>0</max_vel></ode></contact><friction><ode/></friction></surface>
      </collision>
    </link>
    <joint name="rotor_2_joint" type="revolute">
      <parent>base_link</parent>
      <child>rotor_2</child>
      <axis>
        <xyz>0 0 1</xyz>
        <limit><lower>-1e+16</lower><upper>1e+16</upper></limit>
        <dynamics><spring_reference>0</spring_reference><spring_stiffness>0</spring_stiffness></dynamics>
      </axis>
    </joint>
    <link name="rotor_3">
      <gravity>true</gravity>
      <self_collide>false</self_collide>
      <velocity_decay/>
      <pose>-0.1591 -0.1591 0.062 0 0 0</pose>
      <inertial>
        <mass>0.0095</mass>
        <inertia>
          <ixx>2.1e-07</ixx><ixy>0</ixy><ixz>0</ixz>
          <iyy>1.05e-05</iyy><iyz>0</iyz><izz>1.07e-05</izz>
        </inertia>
      </inertial>
      <visual name="rotor_3_hub">
        <geometry><cylinder><radius>0.008</radius><length>0.006</length></cylinder></geometry>
        <material>
          <ambient>0.15 0.15 0.16 1</ambient>
          <diffuse>0.15 0.15 0.16 1</diffuse>
          <specular>0.1 0.1 0.1 1</specular>
        </material>
      </visual>
      <visual name="rotor_3_blade_0">
        <pose>0.0480 0.0000 0 0 0.06 0.0000</pose>
        <geometry><box><size>0.081 0.017 0.0016</size></box></geometry>
        <material>
          <ambient>0.24 0.26 0.20 1</ambient>
          <diffuse>0.24 0.26 0.20 1</diffuse>
          <specular>0.15 0.15 0.15 1</specular>
        </material>
      </visual>
      <visual name="rotor_3_blade_1">
        <pose>-0.0240 0.0416 0 0 0.06 2.0944</pose>
        <geometry><box><size>0.081 0.017 0.0016</size></box></geometry>
        <material>
          <ambient>0.24 0.26 0.20 1</ambient>
          <diffuse>0.24 0.26 0.20 1</diffuse>
          <specular>0.15 0.15 0.15 1</specular>
        </material>
      </visual>
      <visual name="rotor_3_blade_2">
        <pose>-0.0240 -0.0416 0 0 0.06 4.1888</pose>
        <geometry><box><size>0.081 0.017 0.0016</size></box></geometry>
        <material>
          <ambient>0.24 0.26 0.20 1</ambient>
          <diffuse>0.24 0.26 0.20 1</diffuse>
          <specular>0.15 0.15 0.15 1</specular>
        </material>
      </visual>
      <collision name="rotor_3_collision">
        <geometry><box><size>0.1778 0.017 0.0016</size></box></geometry>
        <surface><contact><ode><min_depth>0.001</min_depth><max_vel>0</max_vel></ode></contact><friction><ode/></friction></surface>
      </collision>
    </link>
    <joint name="rotor_3_joint" type="revolute">
      <parent>base_link</parent>
      <child>rotor_3</child>
      <axis>
        <xyz>0 0 1</xyz>
        <limit><lower>-1e+16</lower><upper>1e+16</upper></limit>
        <dynamics><spring_reference>0</spring_reference><spring_stiffness>0</spring_stiffness></dynamics>
      </axis>
    </joint>
  </model>
</sdf>
