Kmedrano101/px4_drone_dev/(commit log)

2026-07-24 Initial commit: PX4 drone indoor-nav dev journal
    Docs, .ulog analysis tooling, firmware version tracking and working
    param backup for a custom PX4 (NxtPX4v2) drone bring-up toward
    autonomous indoor navigation (flow + LiDAR + offboard ROS 2).
    [Key_parameters_MAVLINK.txt, backup_fc_2026-07-23.params]
2026-07-24 Track flashable .px4 firmware in repo (V1, V2)
    Include the QGC-flashable .px4 for each firmware version so they can be
    downloaded and flashed directly from GitHub. .bin/.elf stay ignored.
    Update README (EN/ES) notes accordingly.
2026-07-24 report: mtf01-ekf2-tuning segunda ronda (mag-free, quality 60->78, offset no resetea)
    Actualiza el reporte con la ronda de pruebas tras recalibrar sensores y
    desactivar el magnetometro para indoor: mejora la calidad de flujo optico
    pero persiste la perdida de tracking bajo movimiento y aparece un hallazgo
    nuevo (offset de posicion no se corrige al salir de dead-reckoning).
2026-07-24 report: sync MTF-01 tuning with AI session analysis (§3.6)
    - Refute hypothesis #1 (flow quality): data shows flow is healthy
    (quality 75-78, pixel_flow ~0 on vertical lift) — threshold not the issue.
    - Root cause of lift-drift = IMU dead-reckoning on ground (flow only fuses
    in air); hand-lifting is not a valid flow test.
    - Document mag decision (EKF2_MAG_TYPE=None + SYS_HAS_MAG=0) and the open
    question: does flow fuse in air without a yaw source? -> in-flight test.
    - Strategic direction: 3D LiDAR (FAST-LIO) EV for pos+yaw.
2026-07-30 scripts/: organize log-analysis tools + visual plots
    - Move analyze_* into scripts/, shared _common.py (Okabe-Ito CVD-safe
    palette, consistent matplotlib style, ULog helpers, plot output mgmt).
    - New analyze_temperature.py: FC baro/IMU temp trend + 80/85 C thresholds.
    - Add plots to motor-noise (motors + torque) and takeoff (altitude +
    motors + estimator validity).
    - scripts/input/ (drop .ulg here, read by default) and scripts/output/
    (generated plots); both git-ignored except READMEs.
    - Update README (EN/ES) usage.
2026-09-01 docs+logs: indoor flight test results, motor M4 fix, CLAUDE.md rules
    - CLAUDE.md: add session memory and documentation update rules
    - reports/: add §3.7 to EKF2 tuning report (Case B confirmed in flight:
    cs_opt_flow never fused without yaw → Livox+FAST-LIO path confirmed)
    - reports/: new report for motor M4 — mounting screw shorting winding,
    resolved with ESC swap 50A→60A; balance verified in log 16_28_38
    - README.md: update indoor position hold milestone status
    - logs/: add flight logs from 2026-08-11, 2026-08-12, sess113, 2026-08-25
    Claude-Session: https://claude.ai/code/session_01LuauMMQzV47fEU2MtcLDRe
2026-09-07 FC#2 (vendor 1.14.3): indoor config, MAVLink tooling, platform spec
    Bring-up of the second drone on the vendor PX4 1.14.3 firmware, configured
    for GPS-free indoor navigation with the MTF-01P (optical flow + LiDAR).
    Docs
    - PLATAFORMA_HARDWARE.md: full spec sheet (airframe, FC, sensors, companion,
    firmware versions, comms) with vendor images, plus the SUPER reference and
    the deltas against its BOM.
    - PARAMETROS_INDOOR.md: 68 params in six tiers by importance, with options
    from the 1.14.3 source and current values read from the FC.
    - CONEXION_MAVLINK_SCRIPTS.md: step-by-step MAVLink access over USB cable or
    radio, without QGroundControl.
    - reports/2026-09-04: MTF-01P + param migration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
    [backup_fc_2026-09-04.params, backup_fc_2026-09-04_post-migracion.params, backup_fc_2026-09-04_pre-indoor.params, backup_fc_2026-09-07.params, lidar_barrido_altura_2026-09-07.csv]
2026-09-10 report: EKF2 y flujo optico en el SITL
    Tres parametros migrados del FC real (EKF2_RNG_CTRL=2, EKF2_HGT_REF=2,
    EKF2_OF_QMIN=30) rompian la cadena flujo -> terreno en simulacion y el dron no
    despegaba. El airframe de referencia de PX4 (4021_gz_x500_flow) no toca ninguno
    de los tres: solo apaga el GPS.
    Queda abierto el arranque intermitente (~2 de cada 7): VehicleIMU no empareja
    acelerometro y giroscopo, "validator best: -1" y EKF2 no actualiza nunca. Sin
    causa localizada; se mitiga comprobando "attitude: 1" a los 30 s y relanzando.
    Claude-Session: https://claude.ai/code/session_01THVbqQ8wNTvAjYbLE2nGEC
2026-09-10 Simulacion Gazebo del dron real en la zona indoor escaneada
    Recrea el RJX F450 (MTF-01P de flujo + lidar 1D, LDROBOT D500 2D, Raspberry Pi 4,
    protectores de 7") dentro del local escaneado, para poder probar el codigo de
    navegacion indoor sin volar.
    - docs/SIMULACION_GAZEBO_INDOOR.md: como esta montado y los pasos exactos para
    instalarlo en PX4-Autopilot.
    - gazebo/: copia versionada de los modelos, el mundo y el airframe 4023. Los
    ficheros que mandan son los de PX4-Autopilot (que es upstream y no traquea nada
    de esto); esto es el respaldo, con sync_px4.sh para ir en los dos sentidos.
    - scripts/gazebo/: generadores. muros_cv.py rehace paredes y suelo desde la nube
    con OpenCV; gen_rjx_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
    [indoor_clean_less_dense.stl, indoor_clean_less_dense_collision.stl, indoor_clean_less_dense_columnas.stl, indoor_clean_less_dense_muros.obj, indoor_clean_less_dense_suelo.obj, indoor_clean_less_dense_suelo.stl, indoor_zone.sdf, model.sdf]
2026-09-11 reports: offboard flights 1-2 and estimator/sensor summary (FC#2 1.14.3)
    Three reports from the 2026-09-10/11 offboard field tests:
    - vuelo1: optical-flow quality drops under EKF2_OF_QMIN in flight, 5 s later
    (EKF2_NOAID_TOUT) position goes invalid and PX4 fails over to ALTCTL; once
    position is valid again on the ground PX4 re-enters OFFBOARD by itself and
    only the kill switch stopped it.
    - vuelo2: near miss. With EKF2_HGT_REF=2 and a +2 m setpoint the LiDAR loses
    the ground, its reading falls, the EKF believes it is descending and the
    offboard controller climbs to ~25 m. Also the Pi's NAV_LAND overrode the
    pilot's STAB. The drift at <=2 m comes from the LiDAR under-reading ~40%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
2026-09-16 docs: 2D-LiDAR external vision test plan (moved here from the workspace repo)
    The plan lives next to the flight reports it draws its conclusions from, so the
    RPi only needs this repo. The ROS 2 node itself will go in the workspace repo.
    Claude-Session: https://claude.ai/code/session_01QYcaJqtiRo8wHbndUnmBF8
2026-09-17 docs: measured sensor offsets and the estimator_status_flags constraint
    The 2D LiDAR scan plane sits 11.4 cm above the FC (measured), which is
    EKF2_EV_POS_Z = -0.114 in PX4 but +0.114 in the ROS TF: the Z sign flips
    between FRD and FLU and getting it wrong silently corrects the lever arm
    backwards.
    Also records why the handshake node cannot gate on estimator_status_flags:
    the vendor 1.14.3 compiles a 14-topic DDS list that excludes it, while main
    publishes 28 and includes it, which is why the same node works in SITL and
    stalls on the real FC. The gate has to use vehicle_local_position instead.
    Claude-Session: https://claude.ai/code/sess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
2026-09-17 docs: correct the EV pose_frame recommendation, FRD blocks yaw_align
    ev_yaw_control.cpp sets yaw_align = false on purpose in the FRD branch and
    true in the NED one. Without a magnetometer heading_good_for_control is just
    yaw_align, so publishing FRD leaves it false forever even though the EV yaw is
    being fused. v1.15.0 has the same code, so a firmware update does not help.
    The bridge has to publish POSE_FRAME_NED.
    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
2026-09-17 params: apply the indoor height/offset table over USB (FC#2, verified)
    Measured the 1D LiDAR with the drone standing on its legs: 0.16-0.17 m,
    variance 0. EKF2_MIN_RNG went from 0.10 to 0.17 so the terrain estimate
    starts at the real standing height -- with 0.10 dist_bottom stayed pinned
    at 0.100 while the sensor read 0.167, i.e. the EKF believed it was 7 cm
    below the actual floor at takeoff.
    Applied and saved over USB, then rebooted (EKF2_HGT_REF is
    @reboot_required) and read back: all persist.
    EKF2_HGT_REF 2 -> 0 (BARO -- common.h:118, 0 is *not* range)
    EKF2_RNG_CTRL 2 -> 1 (conditional range aid)
    EKF2_RNG_A_HMAX 12.0 -> 1.5 (measured sensor ceiling)
    EKF2_MIN_RN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
2026-09-17 docs: validate Prueba 2 (EV to EKF ground test) with 0.046m eph and heading_good_for_control=True
2026-09-17 docs: report and test plan update for Prueba 2b (ground arming in Offboard mode)
2026-09-18 reports: log 158 -- the 1 m EV takeoff is reached; the fall was Stabilized at zero throttle
    Both takeoffs in log 158 reached the 1 m target (EKF +0.98/+0.99 m, 1D
    LiDAR 1.34-1.42 m) and the 1D LiDAR worked throughout: 100 Hz with no
    gaps, 0.17 m on the ground, cs_rng_hgt steady, no rng_fault.
    Attempt B fell because channel 6 went to slot 6, COM_FLTMODE6=8
    (Stabilized), with the throttle stick at -1.00 where Offboard leaves it
    (ignored there): thrust 0.33 -> 0.05, 3.6 m/s descent, roll 173 deg.
    Also confirmed in flight: the EV pose arrives at 20 Hz but only changes
    1.2-1.6 times/s, so ~93% of messages repeat a stale pose with a fresh
    stamp.
    Adds scripts/mavlink/logs.py to list and download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
2026-09-18 reports: the cross-pattern escape was SLAM tracking loss hidden by the bridge
    Cross-checked the FC log with the Pi's ROS logs and the flight rosbag
    (truncated by the impact, read in streaming mode). On leg 1 (+1 m) the
    drone actually travelled ~3 m at ~1.2 m/s -- raw scans show the nearest
    obstacle closing from 3.4 to 0.47 m, and optical flow agrees -- while
    slam_toolbox reported +0.1 m.
    slam_toolbox processed 1.2 of 9.9 scans/s with no odometry prior and a
    +-0.25 m correlation window, so motion between processed scans fell
    outside the window and it returned a false "stationary" match. Its
    covariance rose 50-70x, but the bridge sends position_variance = NaN,
    so EKF2 used EKF2_EVP_NOISE = 0.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
2026-09-18 scripts: evaluate optical flow + 1D LiDAR against tape-measured ground truth
    flow_range_eval.py streams DISTANCE_SENSOR, OPTICAL_FLOW_RAD and ATTITUDE
    over MAVLink at ~45-50 Hz (the nsh listener gave 0.5 samples/s) and
    compares them with a known sensor height and a known hand-carried
    distance. It reports LiDAR bias/noise, flow quality, stationary drift,
    flow scale error (computed with both the LiDAR height and the true one,
    to tell which sensor is at fault) and direction in body axes (to catch a
    wrong SENS_FLOW_ROT). Each run appends to a history file; with two or
    more heights it fits the LiDAR error curve.
    Flow math follows EKF2 1.14.3 exactly (optflow_fusion.cpp:66-67). Notes
    that 1.14.3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
2026-09-18 docs: the Pi venv also needs pyserial for the sensor evaluation
    pymavlink does not pull pyserial in; without it the serial connection
    fails with "No module named serial". Verified end to end from the
    webui afterwards (on the legs, truth 0.17 m: LiDAR 0.173 m, flow
    quality 116, 2 mm drift in 15 s).
    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
2026-09-18 fix(sensor_eval): keep implausible runs out of the LiDAR curve
    A bench run launched with the default ground truth (1.0 m, drone really
    at 0.17 m on its legs, not moved) went into the history and turned the
    LiDAR fit into nonsense (reading = 0.0043 x real + 0.17). Now:
    - a LiDAR error beyond 25% is reported as a probable wrong height input
    and the run is stored with usable_for_curve = 0, excluded from the fit;
    - a move phase under 20% of the expected distance is reported as "no
    movement detected", without a meaningless scale error or direction;
    - an older history file is migrated in place (with a .bak copy).
    Claude-Session: https://c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
2026-09-18 fix(sensor_eval): need heights at least 0.3 m apart before fitting the LiDAR curve
    With valid runs at 0.16 and 0.17 m the fit gave reading = 0.214 x real
    + 0.136 and extrapolated -65% at 1 m: two heights 1 cm apart, measured
    by a sensor with 1 cm resolution, only fit noise. The curve now waits
    for a 0.3 m span. The curve report is its own function so it can be
    tested offline against a history file.
    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
2026-09-18 docs: obstacle stop in the 2D-LiDAR test plan, and where tests 4-5 stand
    Adds section 5.1 (stop at a set distance from any obstacle using the raw
    scan, validated against the crash rosbag and a mock FC), marks test 5
    (cross pattern) as failed on 2026-09-17 with a link to the log 158
    report, notes test 4's horizontal drift, and updates the risks table.
    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
2026-09-18 docs: HOLD and LAND from the webui in the 2D-LiDAR test plan
    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
2026-09-30 docs: ExpressLRS link, and the logs behind the 2026-09-18 analysis
    Radio section filled in from getting the link working again: Jumper AION
    Nano TX on ELRS 3.6.2 LBT (it shipped 3.3.1 ISM2G4), RadioMaster RP4TD-M
    receivers on 3.6.0 CE_LBT binding fine, SpeedyBee ones still to be
    reflashed to LBT. Records the three things TX and RX must share to bind
    -- major version, regulatory domain, binding phrase -- since the domain
    mismatch was what kept them apart, and why Model Match is Off after the
    TX update left the receiver linked but ignoring the sticks.
    Also the evidence for the day's reports: log153 and the flight rosbag of
    the cross-pattern crash, which the obstacle guard was replayed against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
2026-09-30 chore: never commit a log over 5 MB
    Tightens the heavy-log rule from ~10 MB to 5 MB and extends it beyond
    .ulg to rosbags and any other raw data. Drops the two files just pushed
    that break it (log158.ulg, 14 MB, and the cross-pattern rosbag, 8 MB);
    both stay on disk, and their analysis is in the 2026-09-18 report, with
    the scans needed to replay the obstacle guard kept small under
    px4_drone/tools/obstacle_guard/.
    Also writes down why the earlier entry failed: a .gitignore comment must
    be on its own line, or it becomes part of the pattern and matches
    nothing -- which is how the 14 MB log got in.
    Claude-Session: https://claude.ai/code/ses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
2026-10-01 docs: record the u-blox ZED-F9P-02B-01 RTK receiver
    Available but not fitted: FC#2 runs indoor-only (SYS_HAS_GPS=0,
    EKF2_GPS_CTRL=0). Notes what it is for here anyway -- outdoor ground
    truth to quantify SLAM and optical-flow drift, which today cannot be
    measured without a tape -- and the firmware constraint that it has to go
    on GPS1, plus the parameters to revisit before enabling it.
2026-10-01 docs: research gaps for the next paper
    Literature review crossed with what the group already has measured. The
    most promising gap is not algorithmic: robotics map benchmarking (MapEval,
    RA-L/IROS 2025) uses no local-normal comparison, no level of detection and
    no alignment-uncertainty propagation, while geomatics has had M3C2-EP for
    years -- and our own M3C2 runs already show the alignment procedure moving
    reported P50 from 15-22 cm to 2.5 cm on the same maps, a ~9x swing decided
    by the evaluation protocol rather than by the SLAM.
    Also: multi-LiDAR geometry as degeneracy mitigation (what the dual MID-360
    payload can claim beyond "two is better than one"), independent accuracy
    validation of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
2026-10-16 docs: the 1D LiDAR saturation, the MPC design and the PID/MPC protocol
    The last two sessions produced findings and code that only existed in the
    conversation and in px4_drone commits. This writes them down.
    New report: the 1D LiDAR of the MTF-01P is not miscalibrated, it runs out of
    signal over dark concrete. Laser ground truth gives reading = 2.53*(1 -
    exp(-real/2.21)) with a 2.1 cm residual, and that 2.53 m ceiling is the
    TF-Luna spec at 10% reflectivity. So the sensor meets its datasheet and the
    usable band is 1 m, not the 1.5 m assumed so far. Two consequences: the
    EKF2_RNG_A_HMAX we set on 2026-09-17 lets the filter fuse readings that are
    17% short, and the log 158 hover was at 1.66-1.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
2026-10-16 docs: verify the 2D-LiDAR obstacle stop before the PID/MPC runs
    Checked against the code on the Pi, not against the docs. The stop defaults
    to 1.0 m in both launch files and in all three flight cards of the webui, and
    the MPC node inherits it untouched: it only overrides how the setpoint is
    generated, so both runs of the comparison carry the same guard. It can still
    be turned off by hand from the webui by setting 0, so the protocol now says
    to read the node log for "Parada por obstaculo ACTIVA" before each run and to
    discard a flight that says DESACTIVADA.
    It fails to the safe side on every path: no /scan, a /scan older than 0.5 s,
    or under 10% valid rays all refuse to arm and stop the dron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
2026-10-16 docs: name the two webui cards the comparison is run from
    The protocol named the nodes but not what to click, and the cards had just
    been renamed so the PID one says PID. It also now says to launch both from
    the webui rather than by hand: a bare ros2 launch flies the same mission but
    collects no rosbag, no log and no sysmon, so it cannot be compared against
    anything.
    Records that both cards now share their defaults - 0.8 m, 30 s hold, obstacle
    stop at 1.0 m - so that launching them as they come produces two comparable
    runs, and that the only thing allowed to differ between A and B is the
    controller.
    Claude-Session: https://claude.ai/cod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
2026-10-16 docs: the Pi is built and serving the new cards, with two gotchas recorded
    The workspace rebuilt clean (FIN_RC=0) and both binaries carry the 1.0 m
    ceiling: takeoff_position_hold_ev was compiled at 11:09 and
    takeoff_hold_land_mpc at 12:51, both after the header changed at 11:08. The
    webui is restarted and serves nine collapsible panels, the PID and MPC cards
    by those names, and 0.8 m / 30 s / 1.0 m on both.
    Two things that made this harder than it should have been, now written down.
    The workspace uses --symlink-install, so everything under install/lib is a
    symlink created once: its own date is a month old while the binary behind it
    is minutes old, and reading the wrong one says the build di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
2026-10-16 docs: the RC switch gate, verified and with the hole it had
    Kevin asked to verify that offboard only runs with the RC switch in offboard
    and does not start otherwise. The entry gate was there and correct: the node
    never forces OFFBOARD, it waits for nav_state_user_intention - the pilot's
    own switch - before asking for the mode, and aborts after 10 s without
    touching OFFBOARD or ARM. The in-flight direction was there too, checked
    every cycle, and it stops publishing rather than taking control back, which
    is the lesson from the 2026-09-11 flight where a LAND from the Pi overrode
    the pilot.
    What was missing is now written down as well: the switch was read once, and
    up to 13 s pass before the A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
2026-10-16 docs: how to check a test will launch, without flying it
    The "was not found in the share directory" error came from launching while
    colcon had the share directory empty. The webui already refuses to offer a
    card in that state, but after a build it is worth proving it from a clean
    environment, which is also what the Pi looks like after a reboot: env -i plus
    the three setups the webui itself sources, then ros2 launch --show-args, which
    resolves the launch file and flies nothing, and ldd, which must print no
    unresolved library so acados/lib is coming in through the environment hook.
    Claude-Session: https://claude.ai/code/session_01QYcaJqtiR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
2026-10-16 docs: the webui's Limpiar button clears the view, not the log
    Says plainly that it never truncates the file, since that file is the record
    the flight gets analysed from, and that a new test shows everything again.
    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
2026-10-19 docs: add desktop RViz LiDAR launcher
2026-10-19 chore: ignore local PID MPC artifacts
2026-10-20 docs: the obstacle that stopped both cycles was never there
    The 2026-10-16 PID and MPC runs both landed on an obstacle, and the report
    written on the 19th left open whether the 0.95 m return behind the drone was
    real, asking for a physical inspection of the rear sector. The rosbags close
    it: there is nothing to inspect.
    With the props stopped the LD19 returns nothing under 2 m in 655 scans over
    66 s, so no part of the airframe sits in the scan plane at rest. The moment
    the props spin up a burst appears, 0.6 s while climbing and 1.6 s with the
    drone still on the ground at takeoff thrust, across opposite bearings at once
    and with the same bearing band reporting 0.921, 1.027 and 0.982 in
    conse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
2026-10-20 docs: the pillars are 40 cm wide, and that is the whole fix
    The test field has four pillars about 40 cm across and nothing else, which
    the pilot pointed out while we were reading the bags. An object's angular
    size depends on its distance, so asking for a fixed ray count is blind to
    distance; its real width is not.
    Measured on the LD19 at 506 rays per turn: the dust the props lift gives
    chords of 0.03-0.09 m inside the band that triggers, a 40 cm pillar at 1 m
    gives 0.40 m, and the real obstacle in the crash bag gives 1.18-1.83 m. A
    factor of fourteen between the worst dust and the smallest real cluster.
    The replay table in the report now shows that the width filter alone, at
    0.10 m, clears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
2026-10-20 docs: three MPCs, and why the modern one only flies the hold
    The MPC doc now describes the three predictive controllers the cycle can run
    and is explicit that they are not three versions of one thing: the kinematic
    triple integrator that sends acceleration, the same binary with a
    disturbance state (offset-free, so a constant thrust or mass error no longer
    leaves a standing bias in the hold), and a CTBR NMPC with attitude in the
    model that sends body rates and collective thrust, which is what the agile
    literature publishes.
    The CTBR solver was benchmarked on the Pi: 2.67 ms mean, 5.87 ms worst over
    250 solves, so 50 Hz uses 29 % of the loop and 100 Hz 59 %. Faster than the
    kinematic one. Mea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
2026-10-20 docs: what a second reading of the CTBR node found
    Reading the node as a reviewer rather than its author turned up four
    defects, all on the same seam: the boundary between "we publish" and "we
    must no longer publish".
    The fast loop never checked the phase. When the hold ends the base sends
    NAV_LAND, and when the pilot takes over controlLostDuringFlight leaves the
    state in kFinished and the base goes quiet -- but the 50 Hz timer kept
    injecting vehicle_rates_setpoint into uORB, which the rate controller obeys
    in any mode. That is the 2026-09-11 flight-2 class of accident. The release
    path published a position setpoint and a heartbeat even when control was
    already gone; the engage path let PX4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
2026-10-21 docs: the 20-Oct outing produced no flights, and why
    Five runs in three minutes, none of which created a single ROS node. The
    report walks the logs: the third line of each says eth0 does not match an
    available interface, CycloneDDS then refuses to create the domain, and the
    launch, the bag recorder and the load monitor all die the same way. The
    pin went in the day before so desktop RViz could reach the Pi over Ethernet,
    and the car park has none.
    It records the reproduction, the fix verified in all three network states
    including no network at all (every DDS participant lives on the Pi), the
    trap that fooled the first attempts -- the ros2 daemon answers with its own
    configuration -- and the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
2026-10-21 docs: the second blocker under the first -- the DDS domain -- and the bench run that found it
    The report now carries the full bench run made once eth0 was fixed: LiDAR
    publishing, SLAM giving a pose, the XRCE session up and the FC client
    "Running, connected" -- and a single /fmu/out topic visible, because the FC
    publishes in domain 0 and the same commit had moved the webui to 10. With
    that, the flight node could never see position or status. The 16-Oct bags
    have /fmu/out because the webui was still on 0 that day.
    The software doc now says the domain is the FC's to set, not a free choice,
    and what changing it properly involves. The desktop RViz script follows.
    The 14-Oct question of whether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
2026-10-21 docs: bench tests without props, with the motors stopped on time
    Several outings have ended without a flight, so the whole sequence up to
    takeoff now gets proven on the bench first. Without props the aircraft
    cannot climb, the altitude error grows and PX4's integrator parks the motors
    at full throttle until someone hits the kill switch; the standing rule was
    not to try it. The new bench mode makes it safe: N seconds after TAKEOFF the
    node sends a forced disarm (param2 21196, the code the commander accepts in
    flight; without it PX4 answers "not landed") and ends the cycle without LAND,
    which the land detector would never grant with the integrator wound up.
    The doc gives the order -- handshak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
2026-10-21 docs: bench cards for all four controllers, and what each one proves
    MPC+ on the bench has one thing to show: the estimated disturbance must stay
    at zero on the ground, because the observer is gated below 0.35 m. CTBR
    never engages on the bench, but it has never run against a real FC, so a
    pass proves the node starts, loads its solver and survives.
    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
2026-10-21 report: all four cycles arm on the bench, and the SLAM runs at 1 Hz because karto rejects the scans
    The first bench session: PID and MPC reached the forced disarm and PX4
    accepted it in 12 ms; MPC+ kept its disturbance estimate at zero on the
    ground as designed; CTBR ran against a real FC for the first time without
    engaging or falling over. The MPC solver under real load is 9.9 ms mean and
    25 ms worst, two and a half times the isolated figure. Everything started
    with eth0 absent. The MTF-01P was simply off, which from the FC looks like
    "never published" and missing SENS_FLOW parameters; the pre-flight script
    now catches it.
    The finding the pilot spotted in the logs is the one that matters.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
2026-10-21 docs: the scan relay, measured -- SLAM pose from 1 Hz to 6.3 Hz on the bench
    The report gains the implementation and the numbers: with the fixed-size
    relay in front of slam_toolbox every scan arrives at 500 rays, karto
    rejects none, and the pose rate goes from 1.06 Hz this morning to 3.84 Hz
    at the old 0.2 s interval and 6.29 Hz at 0.1 s, matching the simulation on
    the bags to a few hundredths; CPU 41 % and 64 % of a core respectively, the
    relay itself 1.3 %. The software map explains why /scan no longer comes
    straight from the driver, and that the SLAM launch and config now live in
    px4_drone instead of unversioned on the SD card. Flight test pending.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
2026-10-21 report: the field afternoon failed on two things, one fixed and one to capture
    Three of the four runs died on the node's own height ceiling because the
    webui let a value above 1.0 m through; that is fixed. The fourth reached the
    arm request and PX4 denied it with pre_flight_checks_pass false, and the
    reason PX4 gives over STATUSTEXT and its event system is not on the 1.14.3
    DDS topic set, which is why every field trip has been blind. The same stack
    armed on the bench that morning, so the stack arms -- something in the field
    differed, and the report refuses to guess which parameter without the real
    reason. arm_watch.py captures it passively; closing it needs one bench arm
    attempt with battery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
2026-10-21 docs: outdoor GPS bring-up with the ZED-F9P, and the compass it does not replace
    The urgent outdoor goal is manual position/altitude hold on the FC#2 with a
    ZED-F9P, no companion. The doc records what that module is -- an RTK
    position receiver with no magnetometer -- and the consequence: altitude hold
    needs no heading and can be flown today, but position hold needs a heading
    source and the F9P single antenna does not provide one, so a compass must be
    added. The firmware does carry the mag drivers (they answer "Not running",
    not "command not found"), correcting the old note. The GPS port is already
    on auto protocol and auto baud, so the receiver self-detects when wired; the
    mode switch has no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
2026-10-21 config(fc): mode switch slot 4 Altitude -> Position for the outdoor GPS test
    Applied COM_FLTMODE4 1->2 over USB (verified, saved): slot 4 is now Position.
    Altitude is retired from the switch at the user's request; the remaining
    non-GPS fallback is Stabilized on slot 6. Switch is now Offboard / Position /
    Stabilized on slots 1 / 4 / 6. The rest of the outdoor profile is still
    unapplied and the GPS/compass hardware is not mounted yet.
    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
2026-10-21 docs: the SparkFun GPS-RTK-SMA (ZED-F9P) has no compass -- confirmed
    The F9P board is the SparkFun GPS-RTK-SMA: a pure GNSS RTK receiver, SMA
    antenna plus Qwiic and USB-C, no magnetometer and no IMU per SparkFun's own
    listing; it connects to the FC over UART, and its Qwiic is 3.3V I2C for
    configuring the F9P, not for a compass. So heading has to come from a
    separate magnetometer, and the only I2C bus on the FC is on the GPS1
    connector, so the compass shares GPS1 with the F9P (Y-cable) or the
    M100-5883 is used alone on GPS1 as a one-plug GPS+compass without RTK.
    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
2026-10-21 docs: GPS1-only topology chosen, and the MP1584EN logged for a future firmware
    The decision is to wire both the SparkFun F9P (RTK) and the M100's QMC5883L
    compass on the GPS1 connector via a Y-cable: F9P on the UART because it is
    the GPS that feeds the EKF (needed to fly RTK), the compass on GPS1's I2C
    because that is the FC's only I2C bus. The normal-vs-RTK landing comparison
    is done with the one F9P by toggling RTCM corrections, not with two
    receivers.
    GPS2 is set aside: its power pin is 12V, and more decisively this vendor
    1.14.3 has no GPS blending or primary params (SENS_GPS_MASK / SENS_GPS_PRIME
    do not exist, verified over NSH), so a second GPS there would neither feed
    the EKF nor giv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
2026-10-21 docs: F9P accepts 5V with 3.3V logic, M100 used compass-only -- wiring detail
    SparkFun's spec confirms the GPS-RTK-SMA takes 5V on its power input
    (regulates to 3.3V onboard) and all its UART is 3.3V TTL, so it powers from
    GPS1's 5V and its UART wires straight to the FC's 3.3V GPS1 UART with no
    level shifter, TX/RX crossed. The M100 is used compass-only: just its four
    V/G/C/D pins (VCC, GND, SCL, SDA), with its GPS R/T left unconnected; the SDA
    label is to be confirmed on the silk since a "D" can read as "O".
    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
2026-10-21 docs: F9P wires on UART1 (RX/MOSI, TX/MISO), not UART2, with DSEL open
    On the ZED-F9P those header pins carry UART1/SPI/I2C on shared physical pins;
    with the DSEL jumper open (the default) they act as UART1, which is the port
    PX4 reads -- so the FC connects to RX/MOSI and TX/MISO (crossed: TX/MISO to
    FC Rx1, RX/MOSI to FC Tx1), not to TX2/RX2 which is UART2. If DSEL is closed
    the pins become SPI and the UART goes silent; it must stay open.
    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
2026-10-22 docs: F9P resuelto (Rx/Tx cruzados) y brújula GY-273 QMC5883L adoptada
    Verificado por USB el 2026-10-22 con el Y cableado (en interior):
    - F9P: era Rx/Tx cruzados. Tras intercambiarlos, `gps status` da UBX, OK,
    115200 (auto), ~1550 B/s y `sensor_gps` publica (fix 0 en interior, normal).
    Cadena F9P->FC->uORB completa; falta el fix real con cielo.
    - Compás del M100: responde en I2C 0x2c = QMC5883P, no el 0x0D del L. Este
    firmware no trae el driver del P (solo en PX4 main/>=1.17, PR #25115 del
    2025-06-30), así que es ilegible en 1.14.3 -> M100 descartado para el rumbo.
    - Solución adoptada: GY-273 (QMC5883L, 0x0D), comprado. Driver presente en
    1.14.3, dirección libre, LDO 3.3V +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
2026-10-22 docs: F9P validado con posición real (fix 3D, 8 sats, eph 6.24 m)
    Captura por MAVLink (GPS_RAW_INT, solo lectura) acercando el dron a una
    ventana, 2026-10-22:
    - Arranque en frío: primeros satélites a t≈219 s, fix 3D a t≈247 s.
    - Mejor marca: 8 satélites, eph 6.24 m (3D); posición coherente (Ávila).
    - Cadena completa OK: hardware → UART → driver UBX → sensor_gps → MAVLink.
    El error de varios metros es esperable por probar junto a una ventana
    (cielo parcial + multipath + modo autónomo sin RTK); eph subestima el error
    real. La precisión se validará en exterior abierto y con RTK. F9P cerrado.
    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
2026-10-22 hardware: soportes 3D — HAT del F9P sobre RPi y cazoleta de la antena BT-560
    Dos piezas imprimibles (STL + generador paramétrico trimesh + plano/render + README):
    - hardware/f9p_hat: HAT plano para el GPS SparkFun ZED-F9P sobre la Raspberry Pi.
    65x56x3, a ras de la Pi; 4x M2.5 pasante (patrón RPi, los separadores del LiDAR
    suben por ahí); 4x M3 en cuadrado de 38 para el F9P hacia el lado USB; ranura del
    header de 40 pines abierta al borde (UART pasa, GPIO libre).
    - hardware/bt560_mount: cazoleta "saco" para la antena RTK Beitian BT-560
    (helicoidal Ø27.3x58.6, SMA abajo). Saco Ø27.8 int / Ø32.8 ext x 10, base
    39.3x42.4x4, Ø12 central para el SMA+cable, 4x M2.5 con counter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
2026-10-23 hardware: base_rpi4 modificada — 85x71, huecos RPi4 a M3 y en posicion fisica
    Deriva de la base de fabrica (100x75x2.5). Dos cambios:
    - 4 huecos de montaje de la RPi4 a M3 (Ø3.2).
    - Placa reducida a 85x71 mm: X=85 situa los huecos RPi4 en su posicion
    real (3.5 mm lado D / 23.5 mm voladizo lado B); Y=71 conserva los 4
    huecos del frame (48x63).
    Incluye generador parametrico (trimesh+shapely), plano 2D, render 3D,
    README y el STL original de referencia.
    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
2026-10-23 hardware: base_rpi4 — esquinas redondeadas con filete R5
    Las 4 esquinas se redondean (parametro CORNER_R=5 mm). El bbox sigue
    en 85x71 y el filete no toca ningun agujero. Plano, render y README
    actualizados.
    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
2026-10-23 docs: brujula GY-273 = HMC5883L (0x1E) y orientacion de montaje
    La GY-273 recibida lleva HMC5883L (0x1E, driver hmc5883), no QMC5883L.
    Anotada la orientacion FRD: chip abajo + X al morro -> CAL_MAG0_ROT=NONE
    (chip arriba -> ROLL_180). Actualizada tabla de sensores, nota GPS (§3),
    §5 punto 2 y BOM.
    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
2026-10-26 docs: pinout real del M100-5883 (orden conector C D R T V G)
    Orden fisico del conector (pin 1->6): C,D,R,T,V,G = SCL, SDA, Rx, Tx,
    Vcc, GND. Corrige la nota anterior que daba las senales sin el orden.
    Anotado en la doc de bring-up del F9P y en la tabla BOM de hardware.
    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
2026-10-26 docs: pinout de la GY-273 (HMC5883L) 5 pines
    Chip arriba, izq->der: DRDY, SDA, SCL, GND, VCC. DRDY sin conectar
    (no se usa por I2C). Anadido en la nota de la brujula del §3.
    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
2026-10-26 docs: la GY-273 'HMC5883L' resulto ser QMC5883P (0x2c) - descartada
    Probado en hardware (2026-10-26): conectada al I2C del Y, escaneo NSH
    en todos los buses -> responde solo en 0x2c (no 0x1E), hmc5883 -X start
    da 'no device on bus', chip marcado HP5883. 0x2c = QMC5883P, sin driver
    en 1.14.3. Los dos compases (M100 y GY-273) son QMC5883P. Solucion
    pendiente: compas con IST8310 (o RM3100/LIS3MDL). Actualizada tabla de
    sensores, nota GPS (§3), §5 punto 2 y BOM.
    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
2026-10-26 backup: params FC#2 1.14.3 (908) pre-reflash a 1.17 (V2)
    Punto de rollback antes de pasar el FC#2 a 1.17 (build V2, que ya trae
    el driver qmc5883p y lo auto-arranca) para poder usar el compas QMC5883P.
    Volcado por USB desde la Pi. Registrado en el INDEX de firmware.
    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
2026-10-26 firmware: V3 limpia/optimizada multirotor (flash 83%) con QMC5883P
    Build para hkust_nxt-dual desde 82e3322e (1.17). Sobre V2 quita camaras,
    gimbal, IR-Lock, LPE (ATTITUDE_ESTIMATOR_Q + LOCAL_POSITION_ESTIMATOR,
    redundante con EKF2), OSD MSP, drivers de distancia nativos, telemetria
    no-MAVLink (FrSky/HoTT/BST), SD_BENCH/STRESS; baro -> solo SPL06; mag ->
    solo QMC5883P. Mantiene MC/EKF2/Navigator, MAVLink+DDS (telemetria
    intacta), Logger, Gyro FFT y MC Autotune.
    Flash 83.06% (vs 92.01% V2, 98.54% V1). Habilita el compas QMC5883P del
    M100/GY-273. Artefactos (.px4/.bin/diff) + README guardados; INDEX
    actualizado. Pendiente: flasheo fisico + restaurar params + recalibrar.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
2026-10-26 firmware: V3 flasheado y verificado en el FC#2 - compas QMC5883P funcionando
    ver all -> 1.17.0 / nxt-dual-custom / e1ca111b. qmc5883p auto-arranca
    (Running I2C Bus 4 0x2C, 0 errores), sensor_mag publica (|B|~51uT). GPS
    F9P OK. Params reseteados a defaults 1.17 (pendiente re-config + calibrar
    brujula). INDEX actualizado: V3 en el FC, V0-vendor pasa a rollback.
    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
2026-10-26 params: FC#2 1.17 config - Position slot4 + fisicas F450 + tuning vuelo suave
    Sobre la base de julio (1.17) re-aplicada la config reciente que faltaba:
    - COM_FLTMODE4=2 (Position, reemplaza Altitude) para outdoor GPS/RTK.
    - Fisicas: CA_ROTOR ±0.159 (geometria F450), MPC_THR_HOVER=0.3,
    EKF2_MIN_RNG=0.17, EKF2_RNG_A_HMAX=1, EKF2_OF/RNG_POS (lever-arms).
    - Vuelo suave (nunca alta velocidad en pruebas): MPC_TILTMAX_AIR=25,
    MPC_XY_VEL_MAX/CRUISE/VEL_MANUAL/TKO_SPEED=1, MC_YAWRATE_MAX=120,
    MC_YAW_P=2.8; SDLOG_MODE=2/PROFILE=3, MIS_TAKEOFF_ALT=5.
    Verificado tras reboot (persisten). Backup del estado actual (939).
    Pendiente: bloque failsafe/offboard + calibracion (acel/giro/nivel/brujula).
    C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
2026-10-26 tools: gps_rtk_validate.py - resiliencia a frames MAVLink corruptos (try/except en connect y muestreo)
2026-10-26 tools: ntrip_rtcm.py - cliente NTRIP VRS + reenvio RTCM al FC (GPS_RTCM_DATA)
    Opcion B para RTK sin QGC: trae RTCM3 de un caster NTRIP (IGN SPTR),
    manda GGA para VRS y lo inyecta en el F9P via MAVLink. Modos --test
    (valida el caster sin FC, para probar en equipo con internet) y
    --sources (lista mountpoints). Config en ntrip.conf (gitignored,
    lleva credenciales); plantilla en ntrip.conf.example.
    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
2026-10-27 config FC#2 outdoor: motor-map fix, perfiles indoor/outdoor, failsafe Land, bateria, NTRIP IGN y tools RTK
    Revision completa de configuracion y preparacion de vuelo outdoor (FC#2, 1.17):
    - Motores: corregido el cruce de cable motor 2<->3 (PWM_MAIN_FUNC 101,104,103,102);
    geometria CA_ROTOR intacta. Docs PLATAFORMA_HARDWARE / INFORME_VUELO.
    - Perfiles de estimacion conmutables (QGC Load-from-file o load_params.py): indoor
    (flujo+LiDAR) / outdoor (GPS fusionado, baro). 9 params: estimacion + failsafe.
    Aplicado el perfil OUTDOOR. Ficheros en backups/profiles/ + backups completos
    (indoor/outdoor) con el motor-map fix.
    - Failsafe de perdida de enlace = Land (NAV_RCL_ACT=3, NAV_DLL_ACT=3):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
2026-10-27 docs: resultado de campo RTK - fixed 91/91, dispersion 2mm (x59), offset autonomo 1.12m
    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
2026-10-27 docs: reporte validacion RTK campo - fixed/2mm + conclusion exactitud vs precision
    - reporte nuevo 2026-10-27_campo-rtk-validado-fixed.md (procedimiento, tabla, conclusion, matiz eph)
    - conclusion absoluto(~1m, igual) vs precision(2mm vs 10cm, x59, lo decisivo) en doc outdoor y README
    - indices reports/README.md y milestone README.md
    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
2026-10-27 fix bateria FC#2: BAT1_CAPACITY=-1 (% por voltaje) - corregir 0% falso a 24.1V
    Causa: conteo de culombios con A_PER_V=17 (corriente sobreestimada ~13.6A reposo)
    consumia los 1300mAh en minutos -> 0% con bateria al 75-80%. Desactivado el
    conteo (CAPACITY=-1), % ahora por voltaje. Backup pre-cambio incluido.
    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
2026-10-27 report: dos vuelos RTK suaves (logs 17/18) - calidad de vuelo + autonomia real 4.8min->~11min con 4500mAh
    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
2026-10-29 docs: reorganizar en referencia/planes/publicaciones/historico + propuesta paper energía/batería
    - docs/ pasa a cuatro subcarpetas con índice en docs/README.md; todos los
    enlaces del repo (README, reports, gazebo, scripts) reescritos y verificados.
    - Nueva revisión de estado del arte y propuesta de paper con datos de campo:
    ECM de LiPo vs Li-ion 21700 identificado desde logs de vuelo, error del
    tiempo restante contra descargas hasta el corte, instrumentación INA228 en
    la Pi y perfiles Offboard con RTK (NTRIP desde la tablet).
    - PDF/HTML de la propuesta en español e inglés con fotos de sensores.
